wero1414/fm1-midi-dongle./README.md

# FM-1 MIDI dongle

A small stick that plugs into the M-VAVE FM-1's USB-C port and gives it a **TRS MIDI OUT** and an
**isolated TRS MIDI IN**. The FM-1 is a USB MIDI device, so the dongle is a USB host built on the
WCH **CH32X035G8U6** (the cheapest WCH part with a full-speed USB host). It works with any FM-1 firmware
that sends MIDI over USB: Melodee, SLOOP, Felucca, Hortator, stock.

- `DESIGN.md`: the locked design, verified pins, open items, firmware plan, cost.
- `BOM.csv`: parts with LCSC numbers and a *Verified* column.
- `fm1-midi-dongle.kicad_sch` / `.kicad_pro`: KiCad 10 schematic (ERC clean). Generated by `tools/gen_sch.py`.
- `fm1-midi-dongle.kicad_pcb`: the board with placement only (generated by `tools/gen_pcb.py`); routing is manual.
- `fm1_dongle.kicad_sym`, `fm1_dongle.pretty`, `fm1_dongle.3dshapes`: project symbols and the exact LCSC footprints
  (from EasyEDA) for every IC and connector. `tools/export_jlc.sh` makes the JLCPCB BOM.

Status (2026-10-17): schematic done; PCB floorplanned (20 x 26 mm, 4 layers, 0.8 mm, placement DRC clean),
routing not started; firmware not started.

## Hardware summary
- USB-C male plug to the FM-1 (host side, 56 kΩ Rp on CC), VBUS through an SY6280AAC load switch set to 1 A.
- USB-C female for 5 V in only (5.1 kΩ Rd on CC1/CC2), no data.
- MIDI OUT: 3.3 V TRS type A (10 Ω tip, 33 Ω ring), PJ-320D jacks.
- MIDI IN: H11L1SM optocoupler, 220 Ω, 1N4148 reverse diode, TRS type A.
- Programming: WCH-LinkE on three bare pads (3V3 / PC18 DIO / GND), no connector.

## License
Hardware: CERN-OHL-P-2.0 (proposed; change if you prefer).
