wero1414/fm1-midi-dongle./case/out/alu_ghost.png

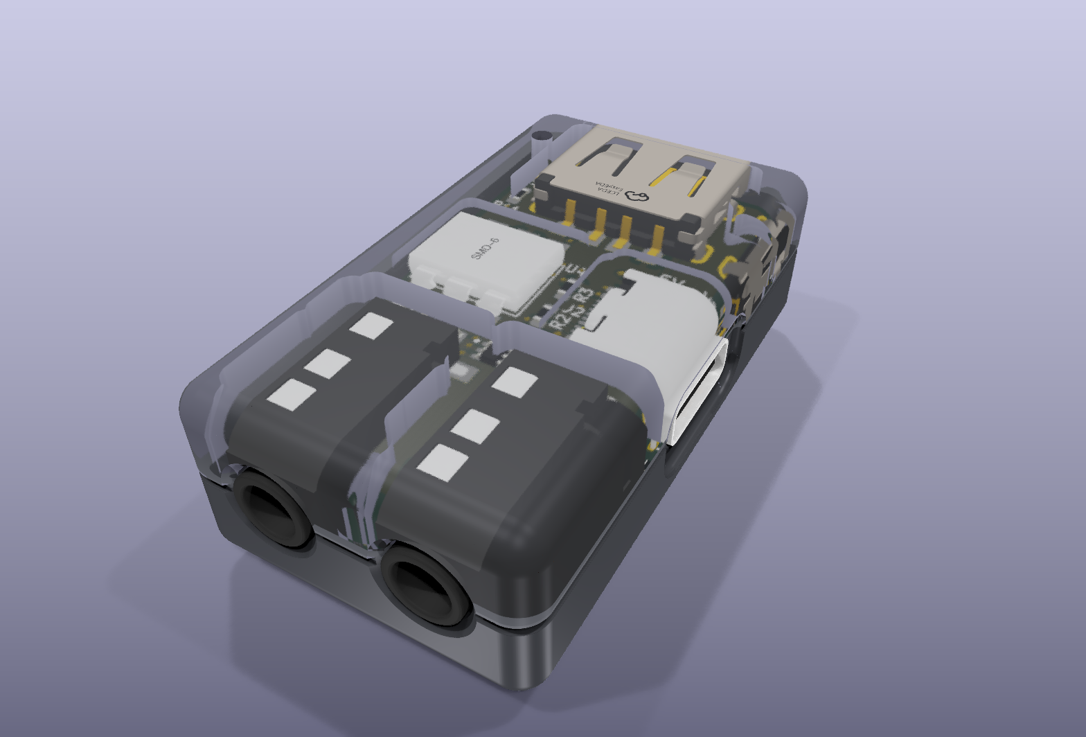
case/out/alu_ghost.png
