wero1414/fm1-midi-dongle./case/out/alu_open.png

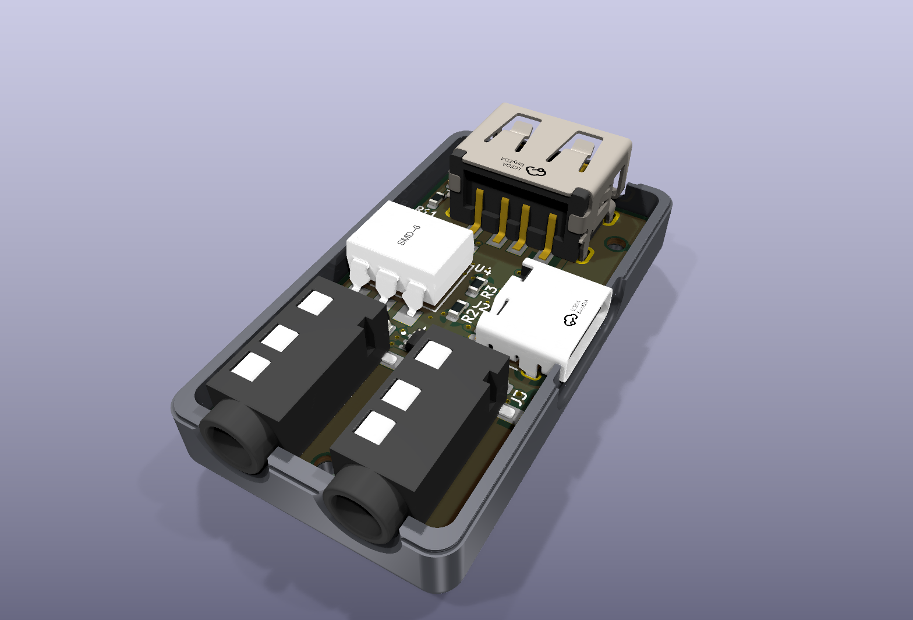
case/out/alu_open.png
