wero1414/fm1-midi-dongle./case/out/alu_side.png

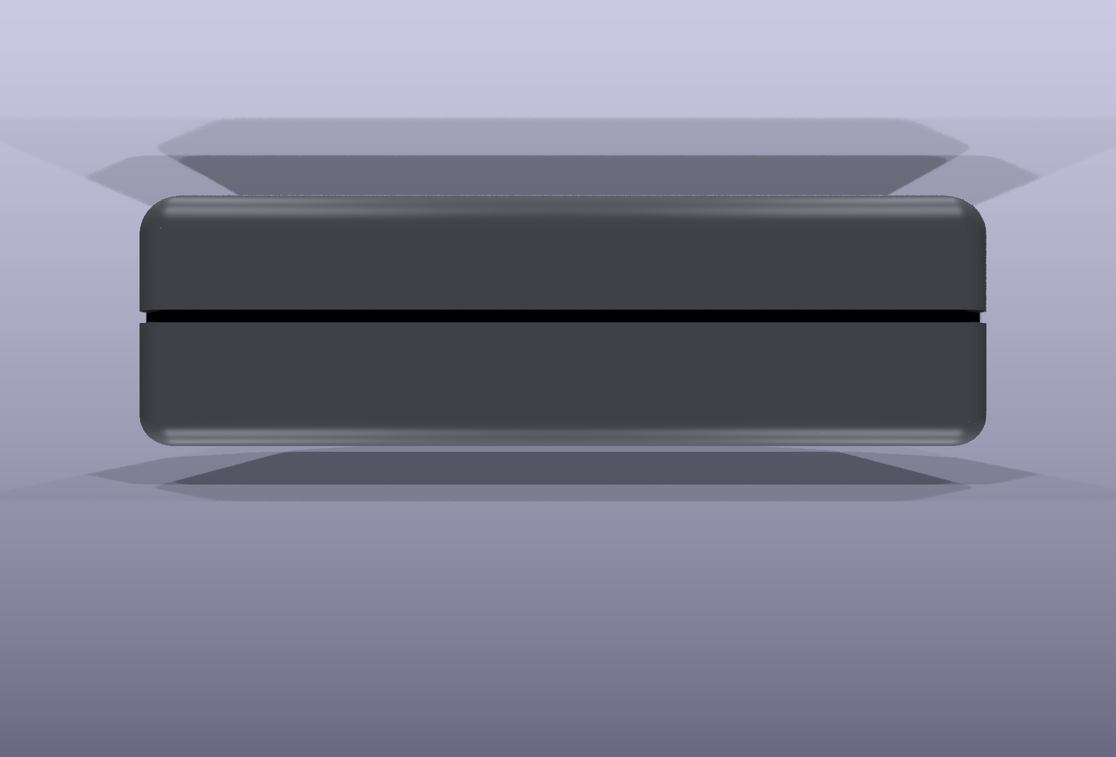
case/out/alu_side.png
