wero1414/fm1-midi-dongle./case/out/case_ghost.png

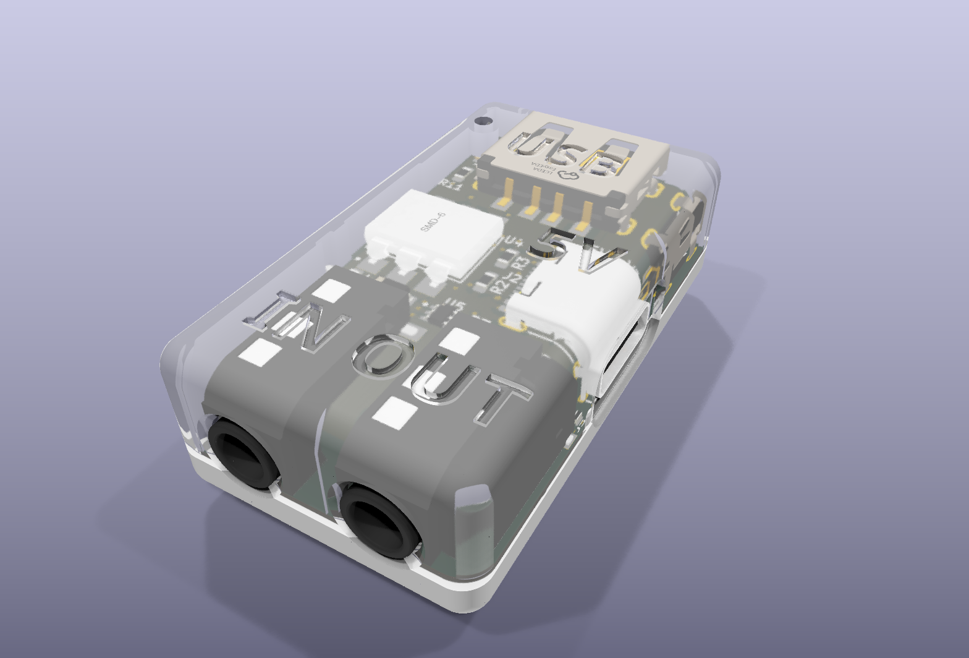
case/out/case_ghost.png
