wero1414/fm1-midi-dongle./case/out/case_open.png

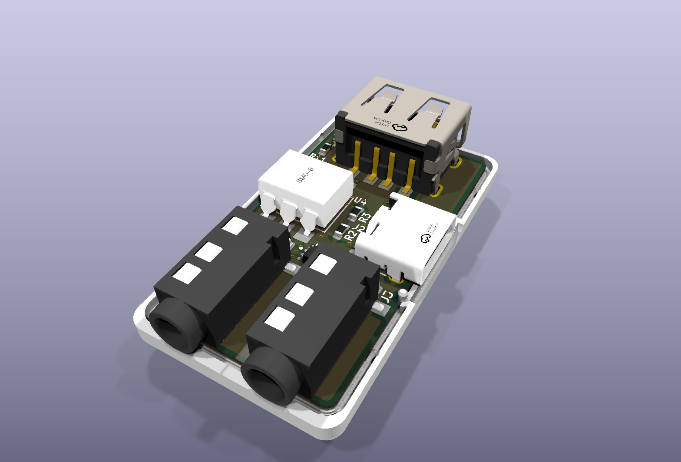
case/out/case_open.png
