wero1414/fm1-midi-dongle./case/out/case_side.png

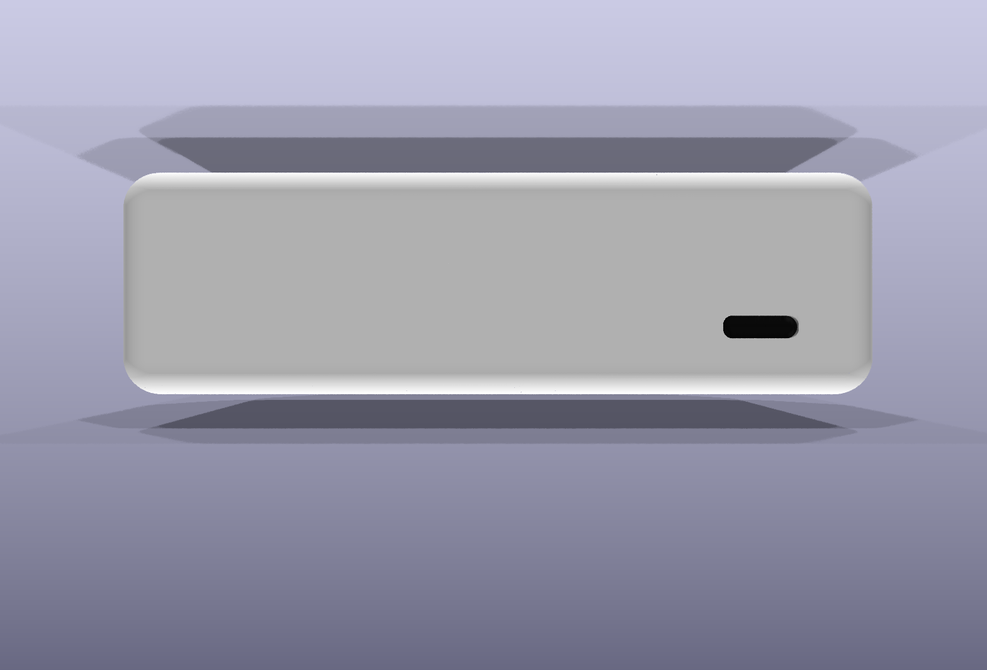
case/out/case_side.png
