wero1414/fm1-midi-dongle./case/out/case_underside.png

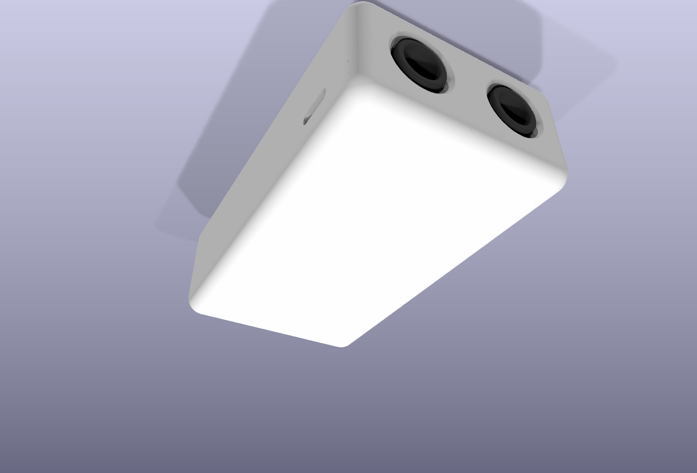
case/out/case_underside.png
