wero1414/fm1-midi-dongle./case/out/case_usb_end.png

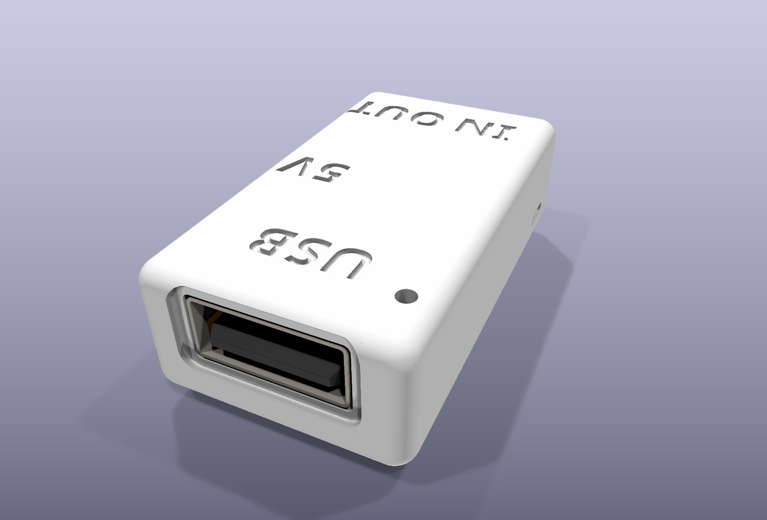
case/out/case_usb_end.png
