wero1414/fm1-midi-dongle./case/out/render_bottom.png

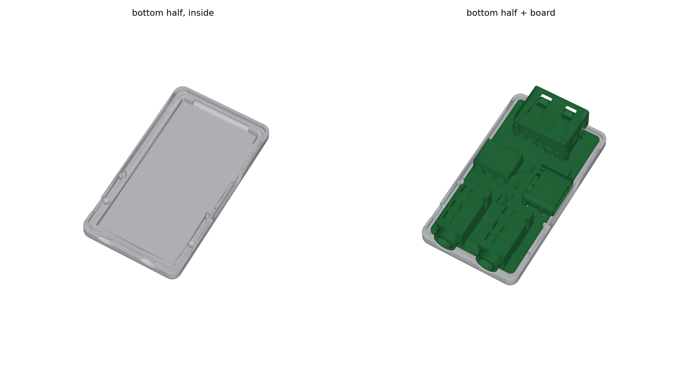
case/out/render_bottom.png
