wero1414/fm1-midi-dongle./case/out/render_exploded.png

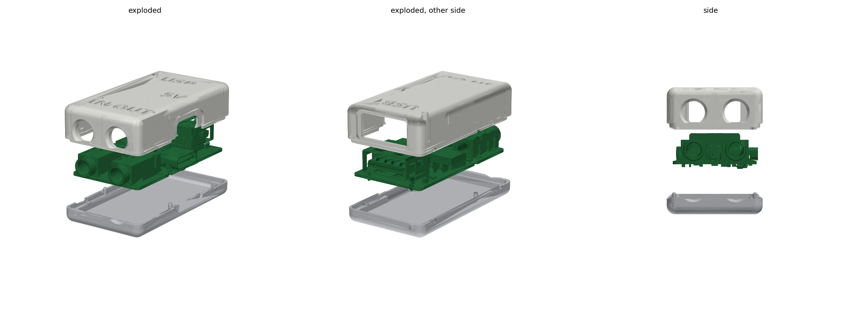
case/out/render_exploded.png
