wero1414/fm1-midi-dongle./case/out/render_halves.png

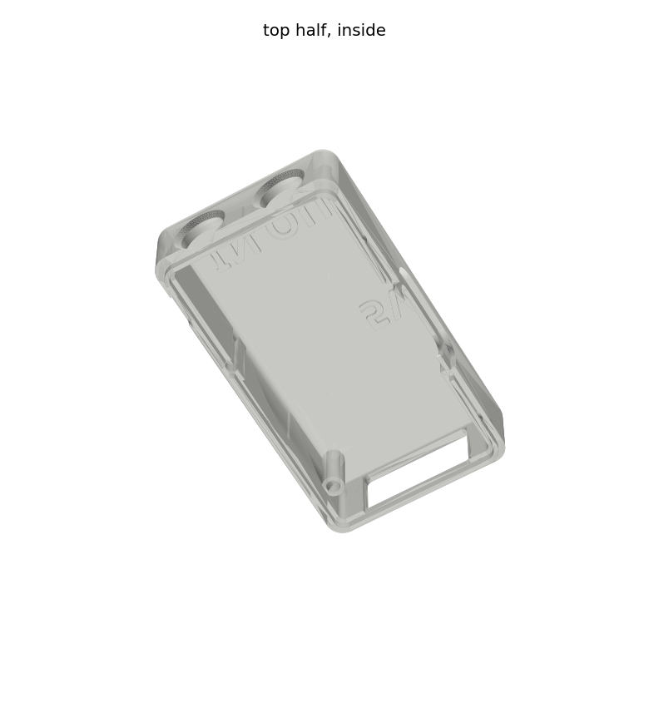
case/out/render_halves.png
