wero1414/fm1-midi-dongle./case/out/sheet_ghost.png

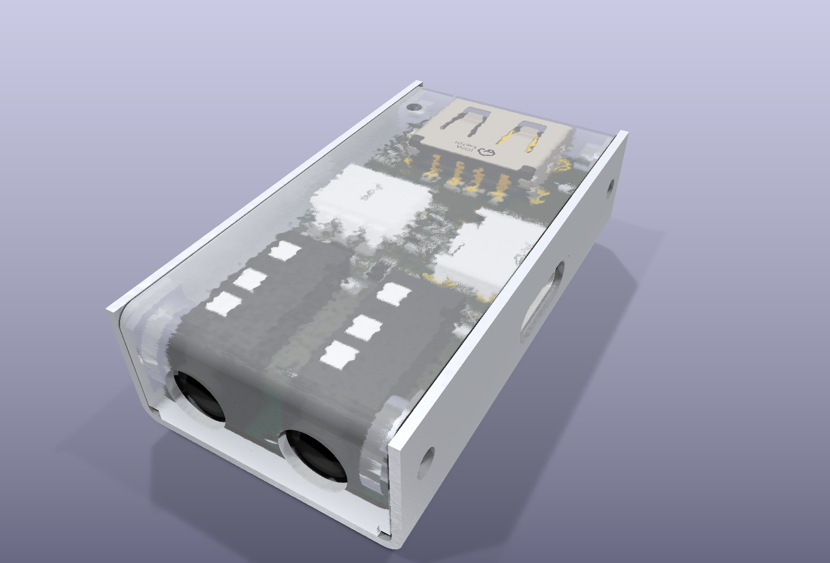
case/out/sheet_ghost.png
