wero1414/fm1-midi-dongle./case/out/sheet_open.png

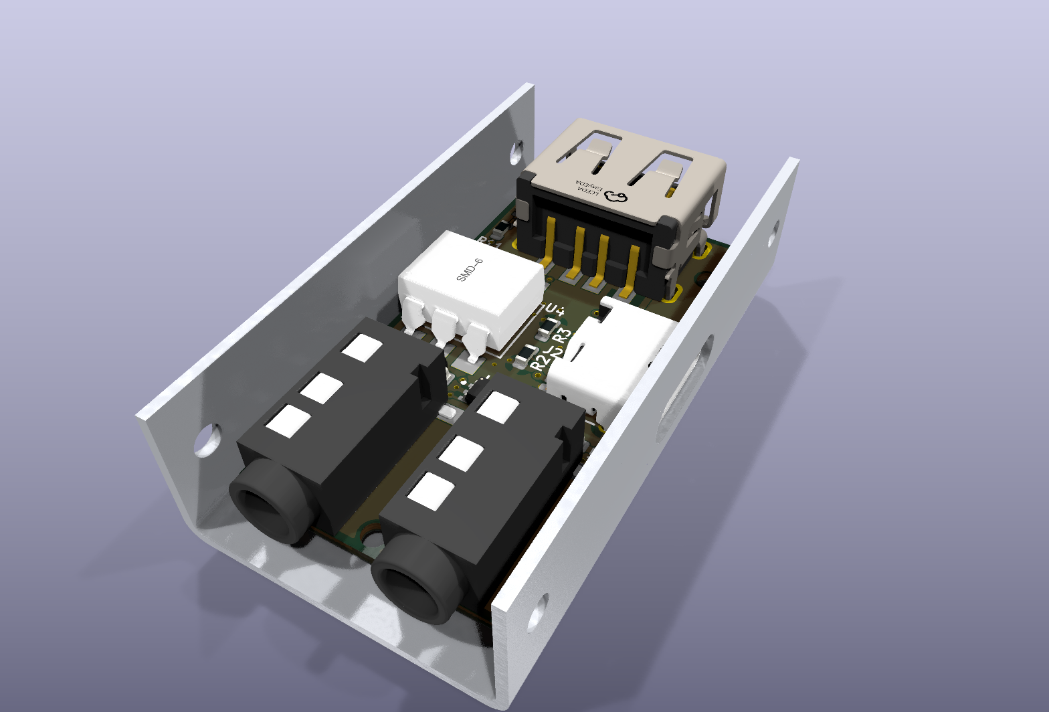
case/out/sheet_open.png
