wero1414/fm1-midi-dongle./case/out/sheet_side.png

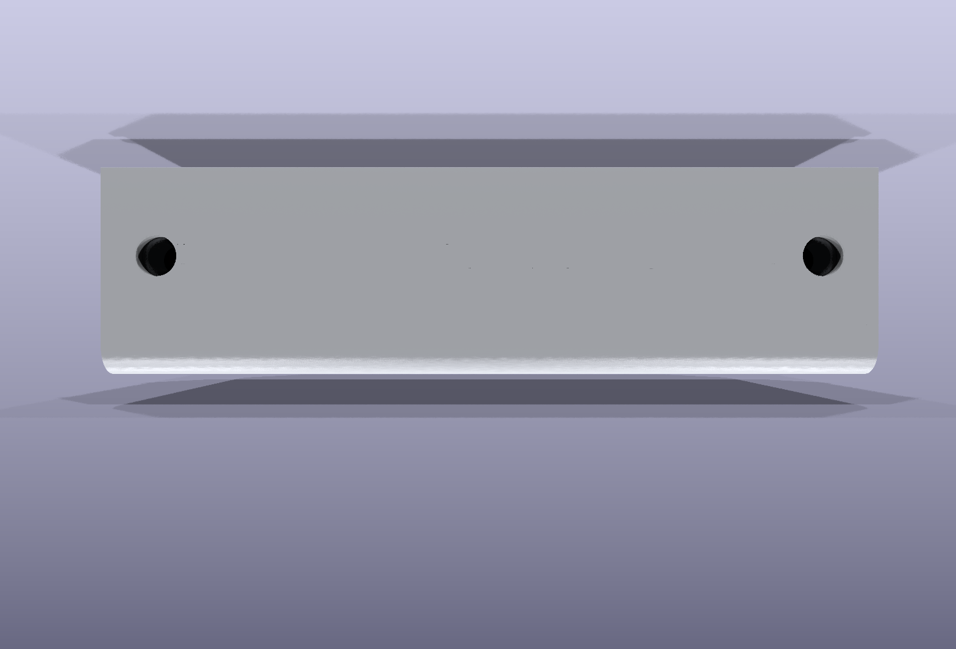
case/out/sheet_side.png
