wero1414/fm1-midi-dongle./docs/pcb3d_iso.png

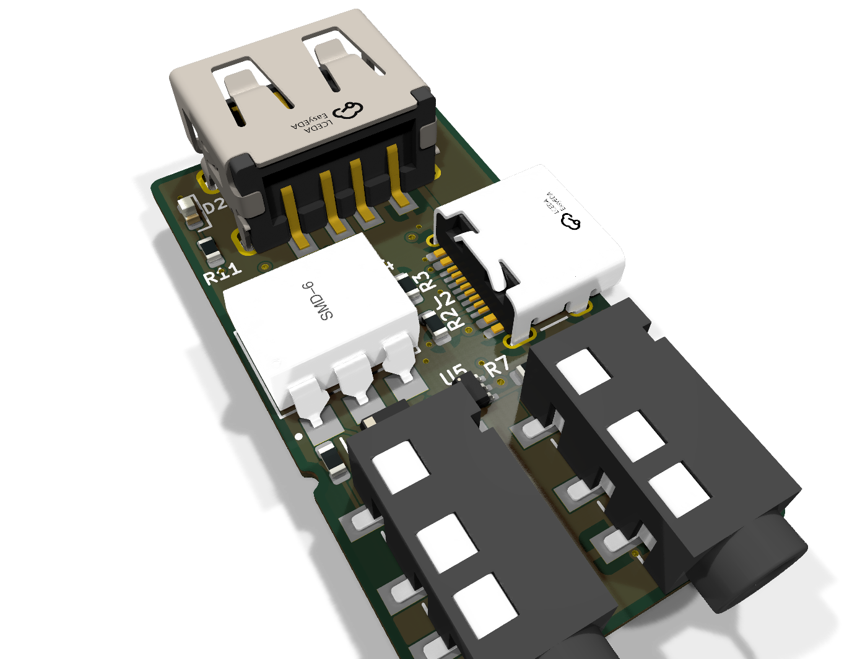
docs/pcb3d_iso.png
