wero1414/fm1-midi-dongle./docs/pcb3d_top.png

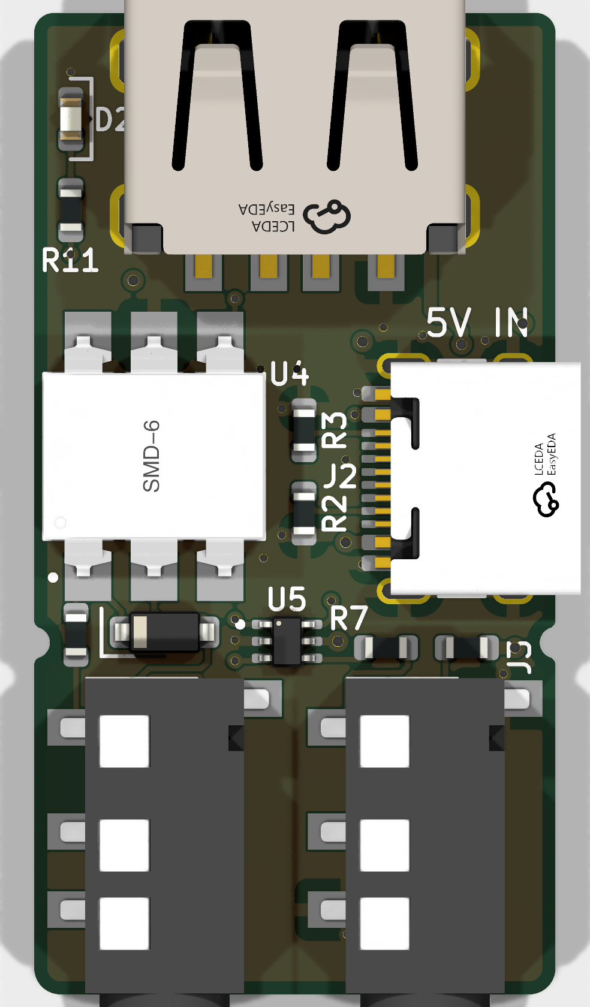
docs/pcb3d_top.png
