wero1414/fm1-midi-dongle./docs/pcb_bot.png

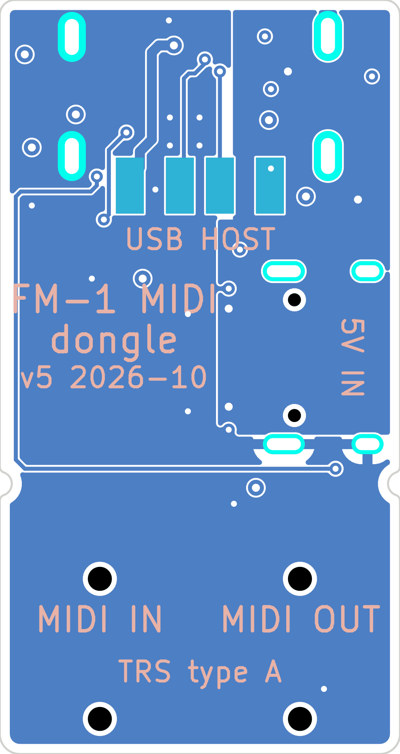
docs/pcb_bot.png
