wero1414/fm1-midi-dongle./docs/pcb_nets.png

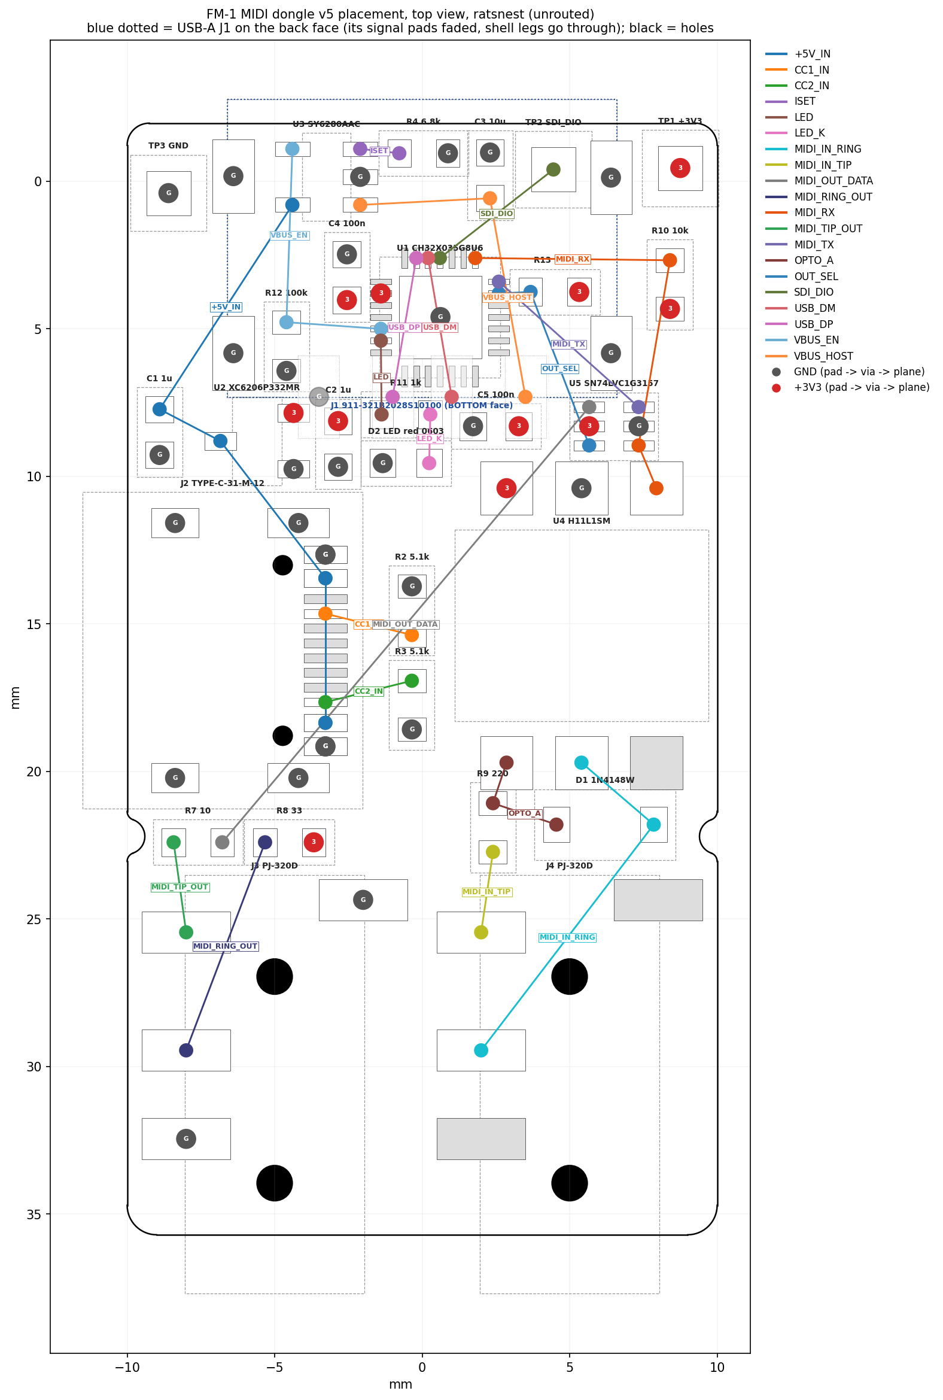
docs/pcb_nets.png
