wero1414/fm1-midi-dongle./docs/pcb_nets_top.png

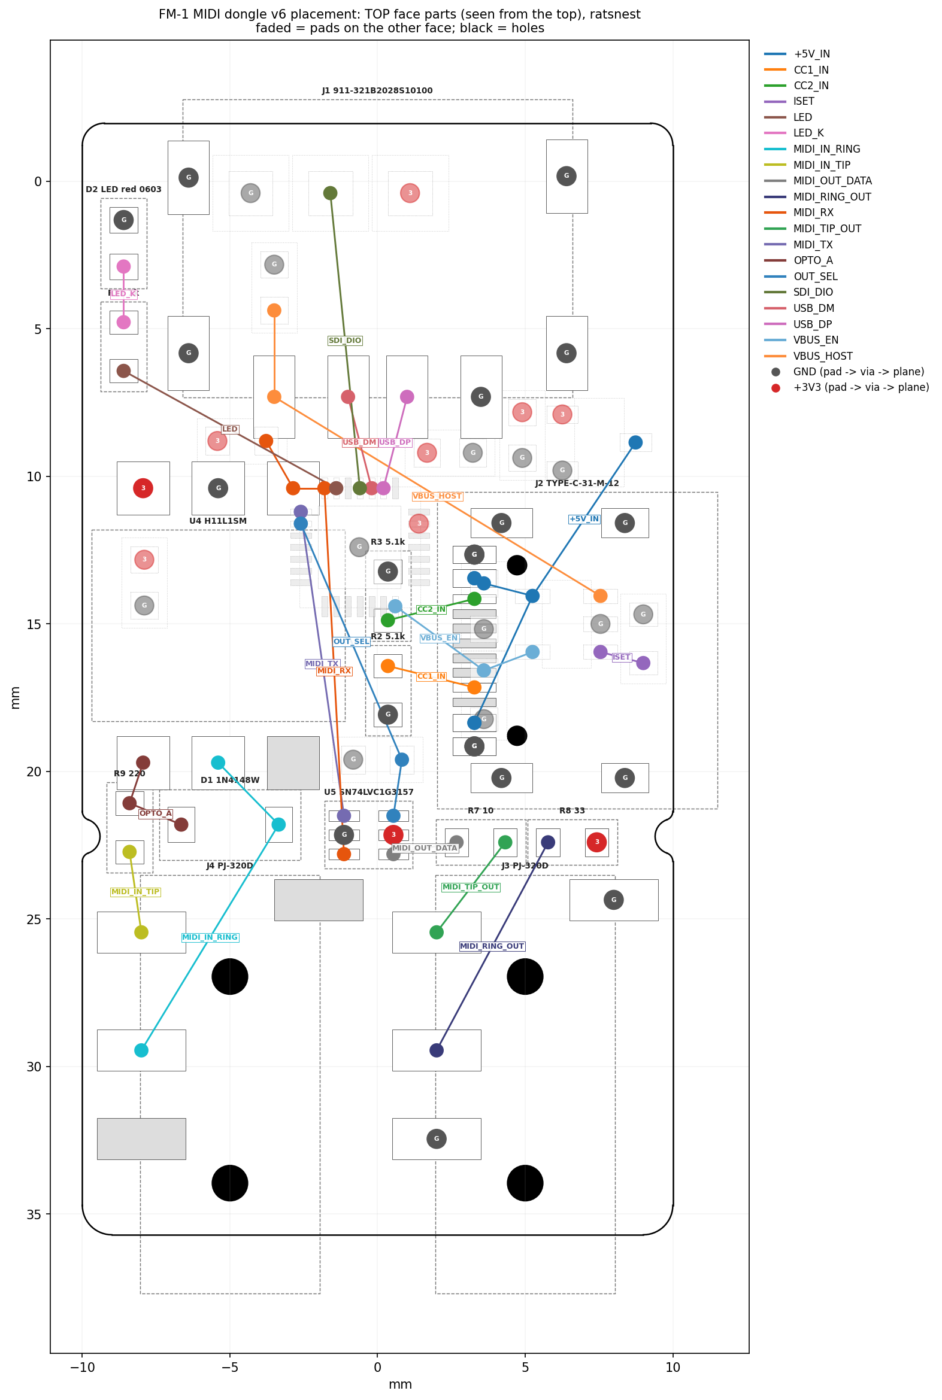
docs/pcb_nets_top.png
