wero1414/fm1-midi-dongle./docs/pcb_route.png

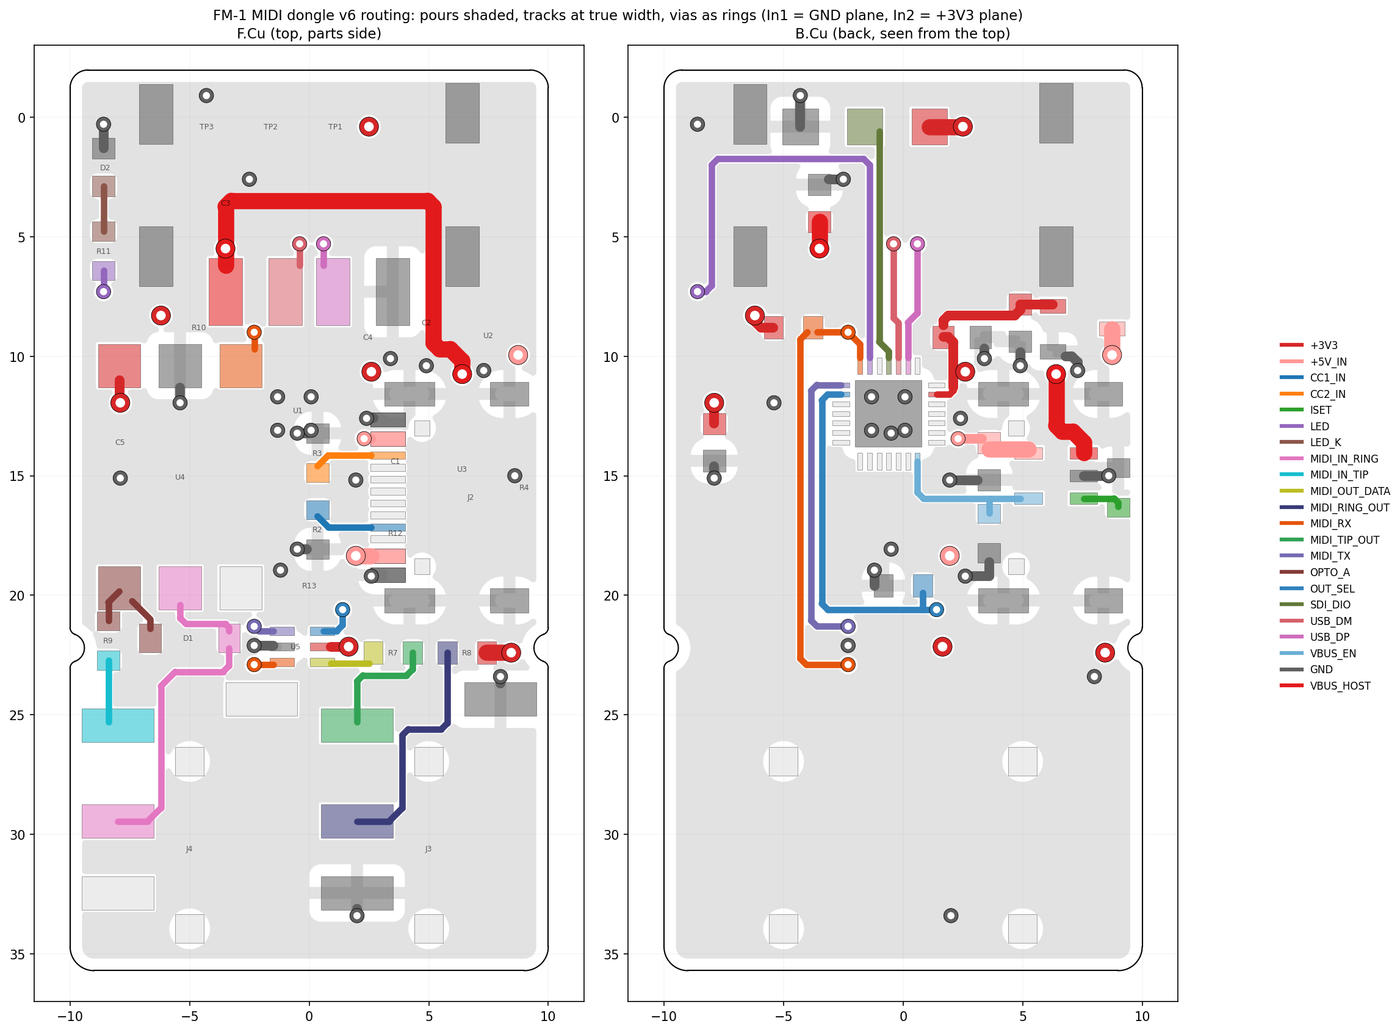
docs/pcb_route.png
