wero1414/fm1-midi-dongle./docs/pcb_top.png

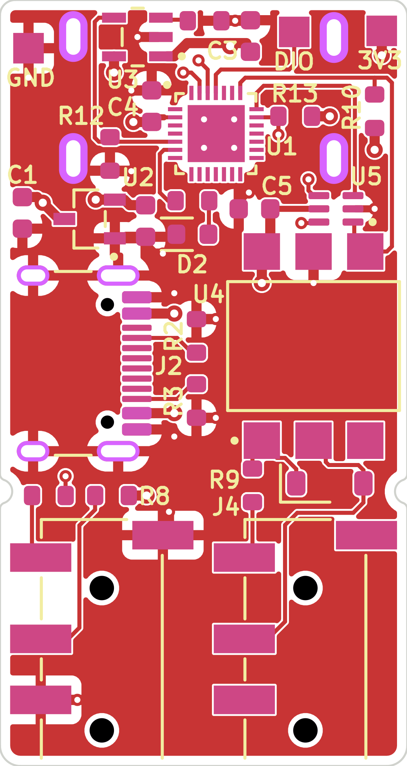
docs/pcb_top.png
