wero1414/fm1-midi-dongle./docs/route_bot.png

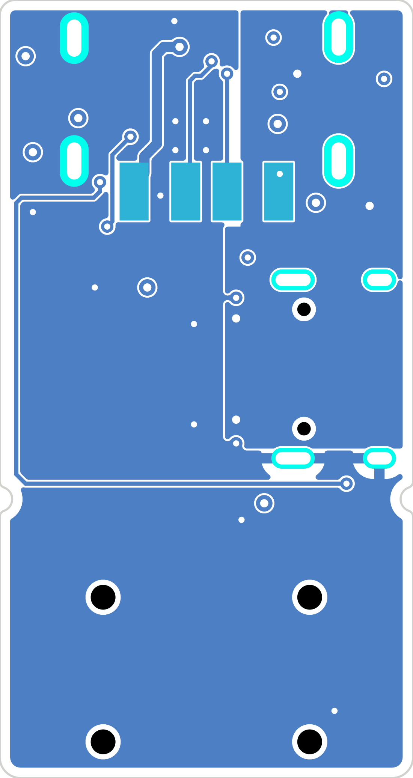
docs/route_bot.png
