wero1414/fm1-midi-dongle./docs/route_in1.png

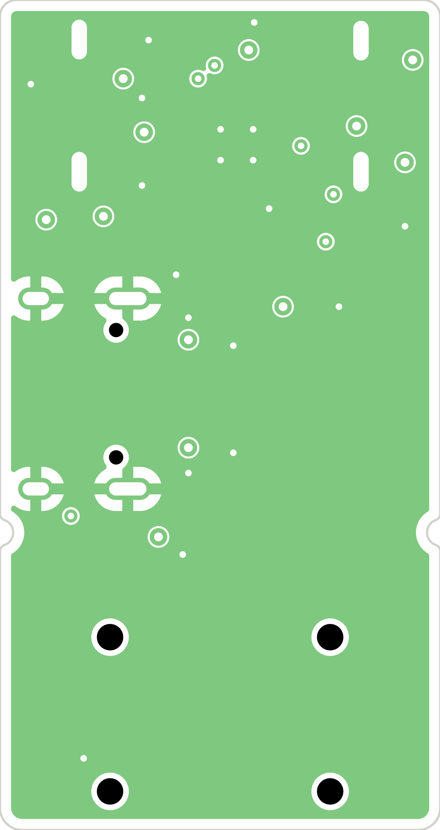
docs/route_in1.png
