wero1414/fm1-midi-dongle./docs/route_in2.png

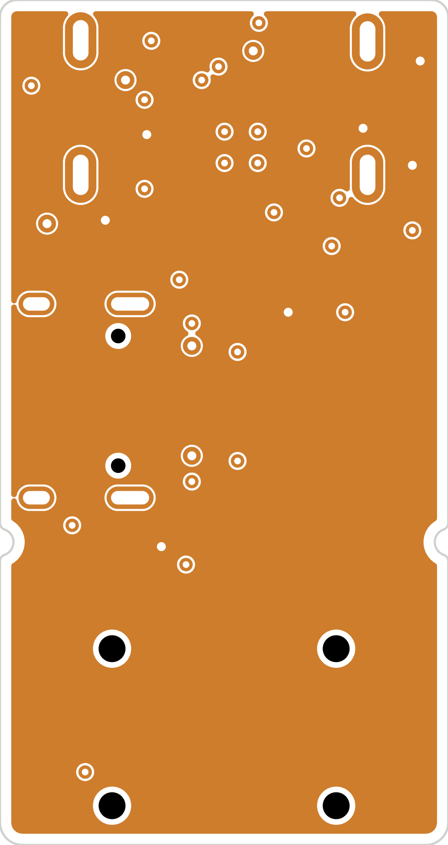
docs/route_in2.png
