wero1414/fm1-midi-dongle./docs/route_top.png

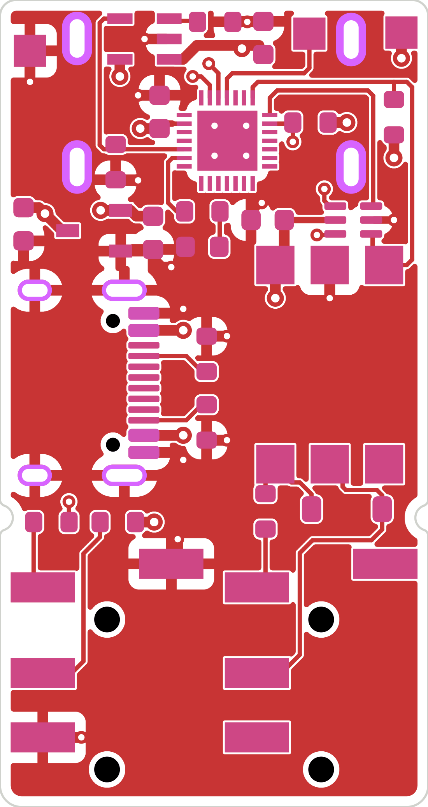
docs/route_top.png
