wero1414/fm1-midi-dongle./docs/schematic.png

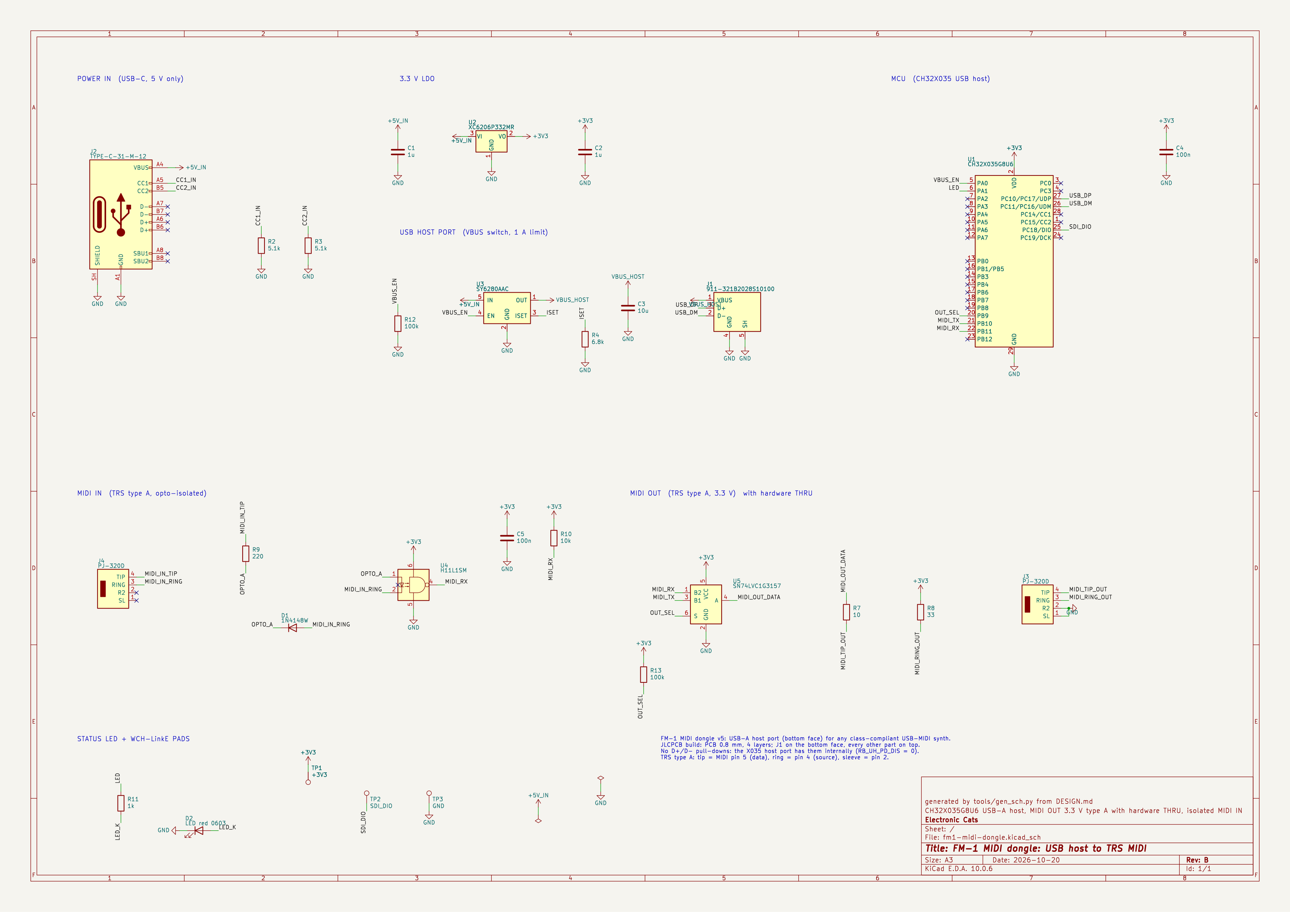
docs/schematic.png
