wero1414/fm1-midi-dongle./docs/silk_bot.png

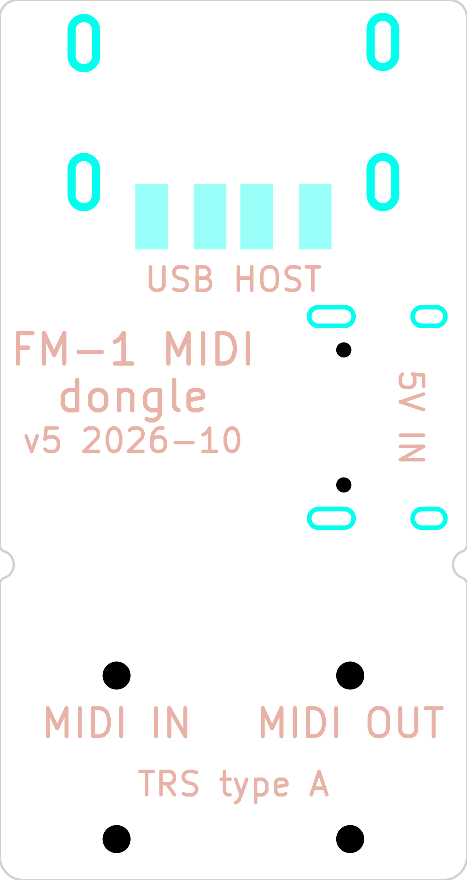
docs/silk_bot.png
