wero1414/fm1-midi-dongle./docs/silk_top.png

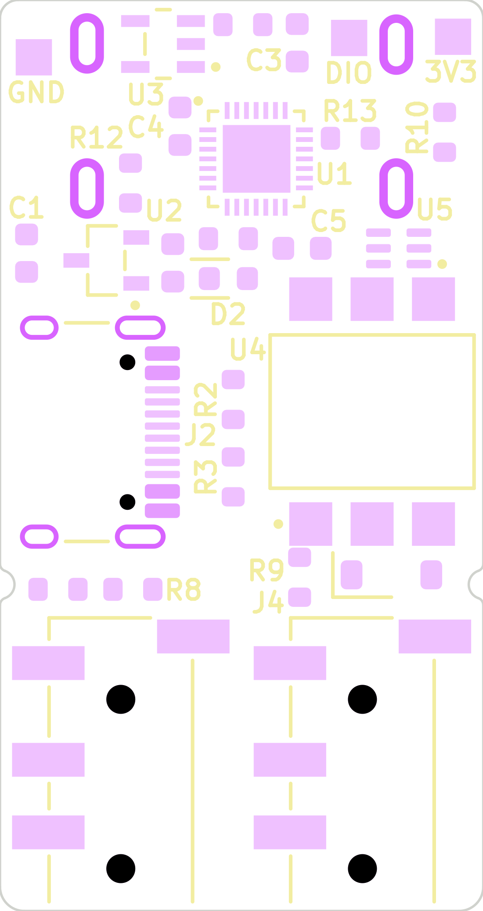
docs/silk_top.png
