wero1414/fm1-midi-dongle./docs/views/bottom.png

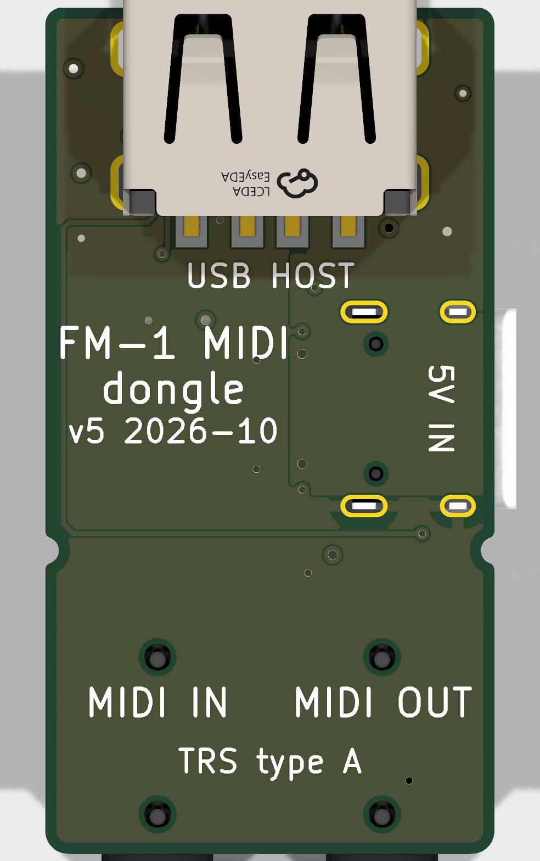
docs/views/bottom.png
