wero1414/fm1-midi-dongle./docs/views/iso_back.png

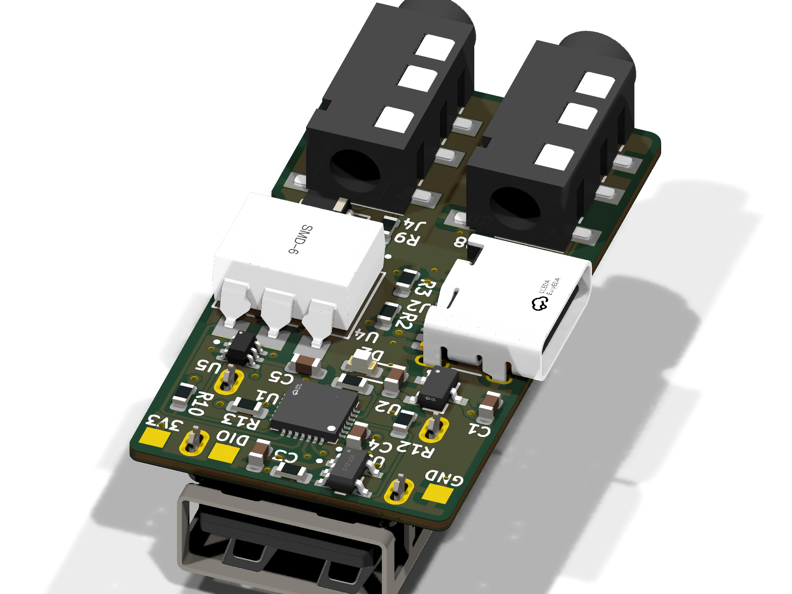
docs/views/iso_back.png
