wero1414/fm1-midi-dongle./docs/views/iso_front.png

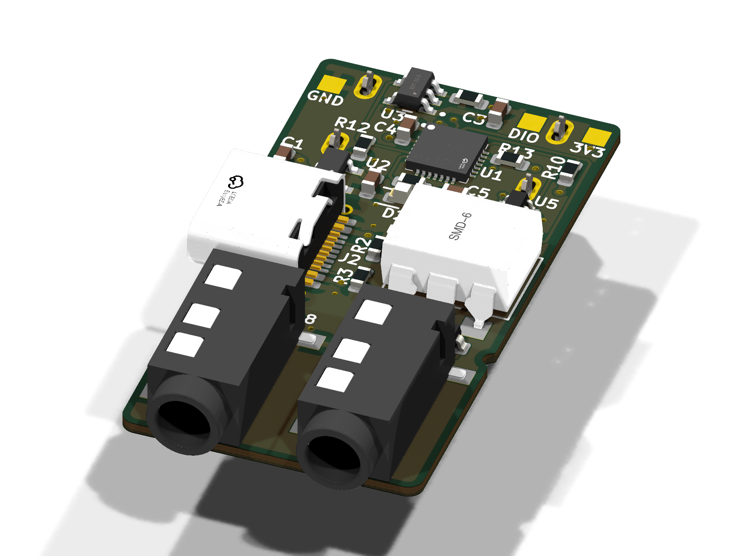
docs/views/iso_front.png
