wero1414/fm1-midi-dongle./docs/views/iso_under.png

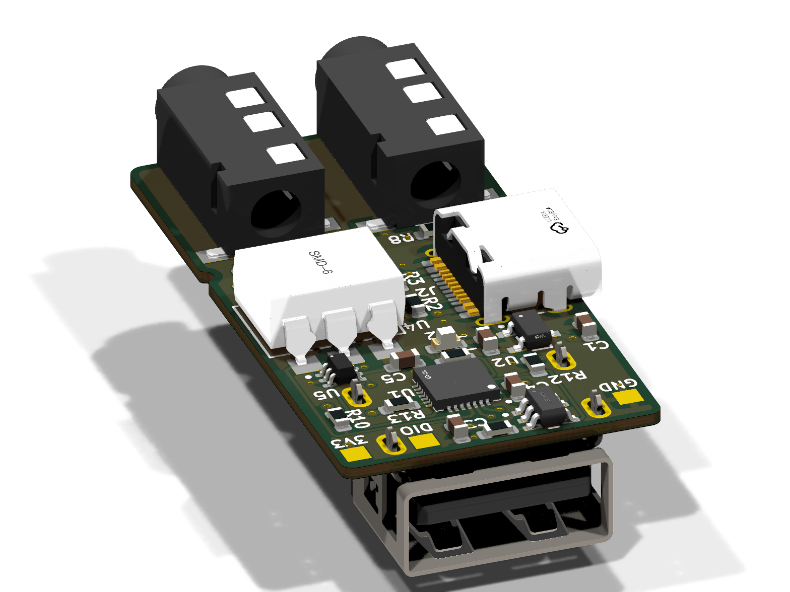
docs/views/iso_under.png
