wero1414/fm1-midi-dongle./docs/views/side_front.png

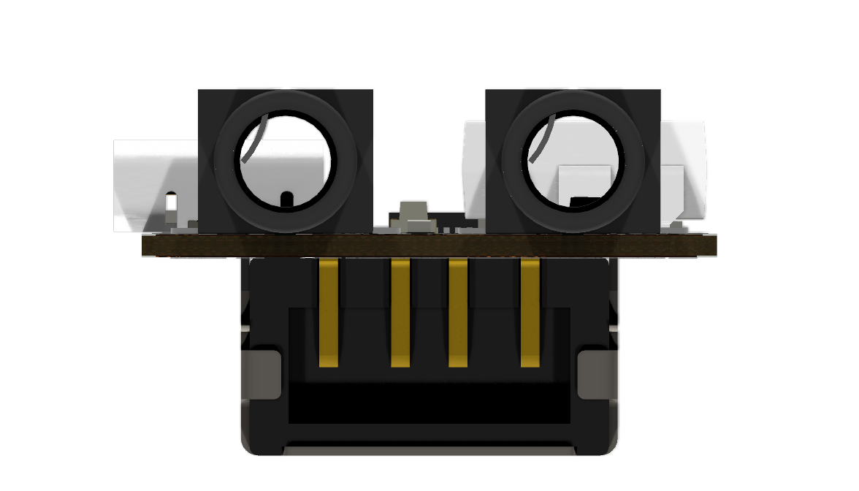
docs/views/side_front.png
