wero1414/fm1-midi-dongle./docs/views/side_left.png

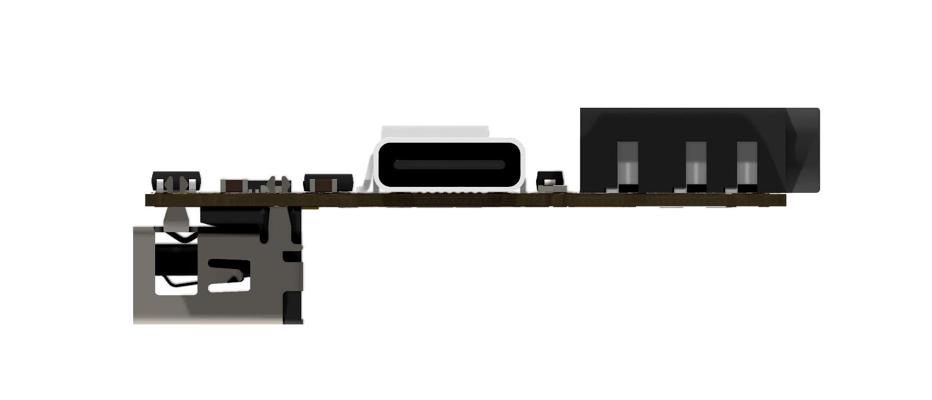
docs/views/side_left.png
