wero1414/fm1-midi-dongle./docs/views/top.png

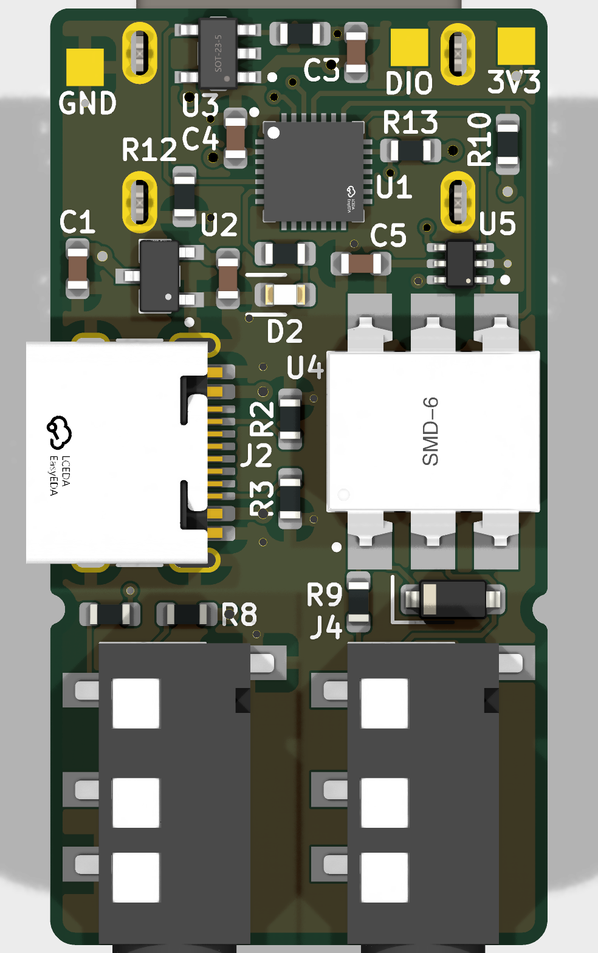
docs/views/top.png
