wero1414/fm1-midi-dongle./case/out/sheet_assembly.step

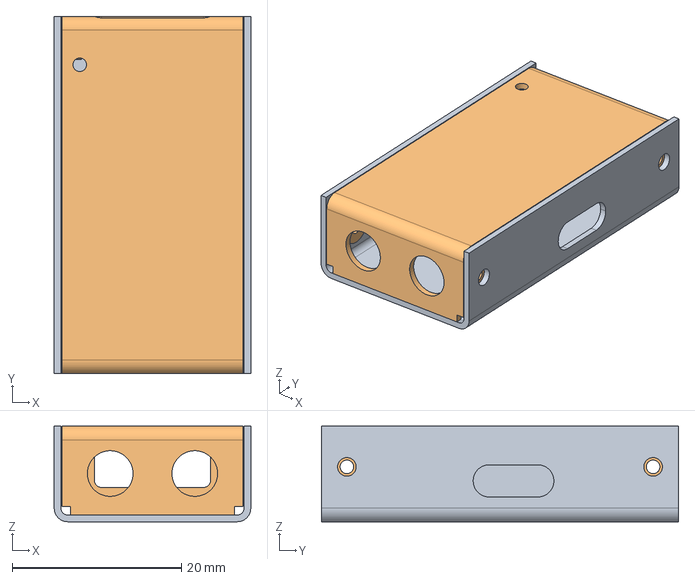
[picture p43: CAD file, 2026-10-21]
case/out/sheet_assembly.step
23.2 x 42.2 x 11.3 mm
