wero1414/fm1-midi-dongle./case/out/alu_assembly.step

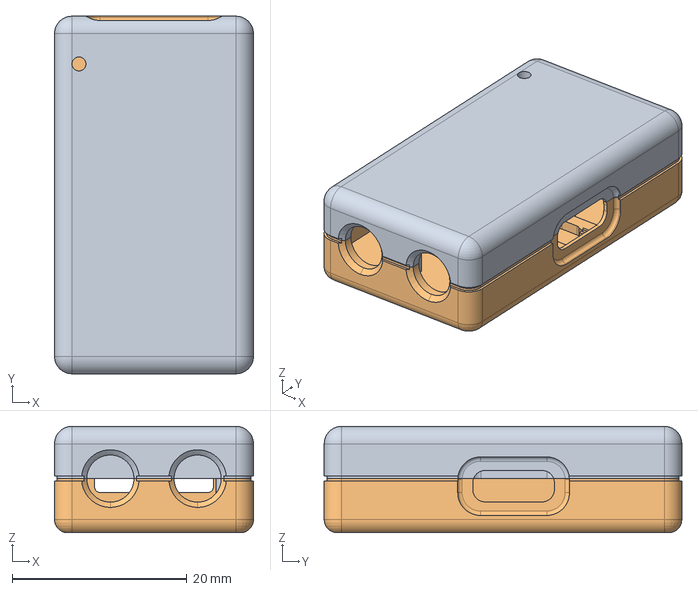
[picture p44: CAD file, 2026-10-21]
case/out/alu_assembly.step
22.8 x 41.0 x 12.2 mm
