wero1414/fm1-midi-dongle./case/out/print_assembly.step

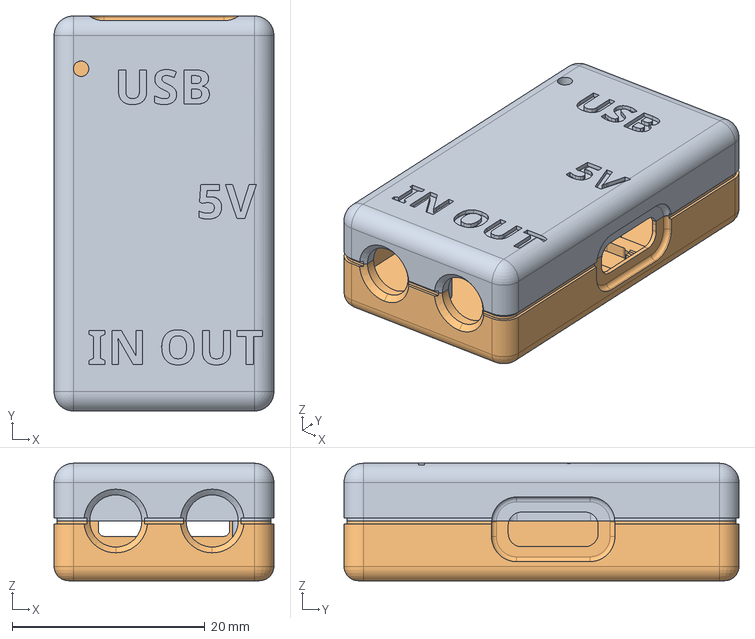
[picture p45: CAD file, 2026-10-21]
case/out/print_assembly.step
22.8 x 41.0 x 12.2 mm
