wero1414/fm1-midi-dongle./case/out/case_assembly.step

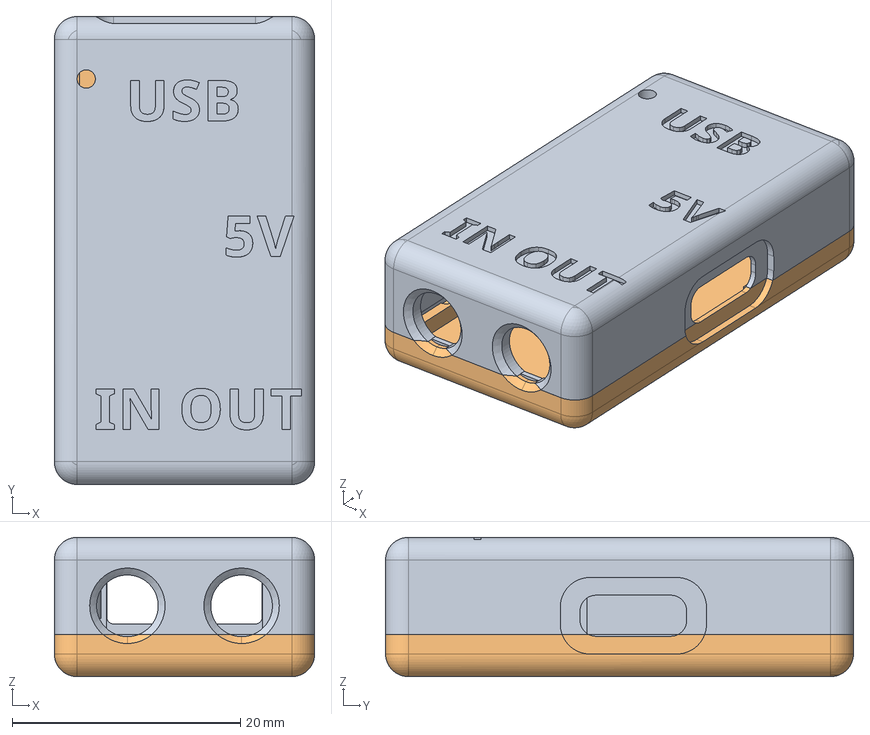
[picture p46: CAD file, 2026-10-20]
case/out/case_assembly.step
22.8 x 41.0 x 12.2 mm
