wero1414/fm1-midi-dongle./case/out/sheet_top.step

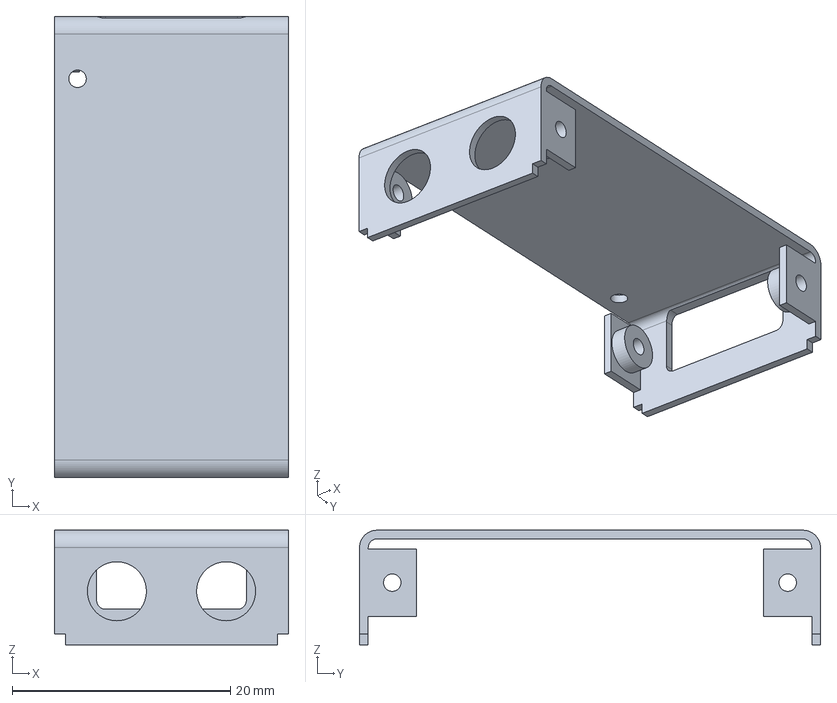
[picture p47: CAD file, 2026-10-21]
case/out/sheet_top.step
21.4 x 42.2 x 10.5 mm
