wero1414/fm1-midi-dongle./case/out/alu_bottom.step

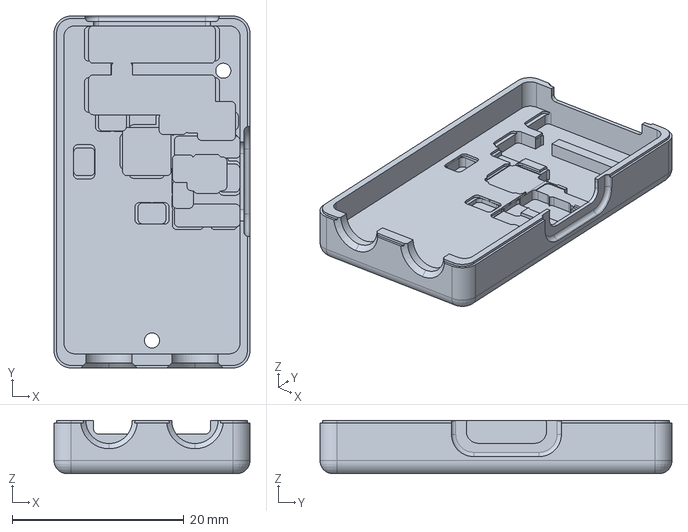
[picture p48: CAD file, 2026-10-21]
case/out/alu_bottom.step
22.8 x 41.0 x 6.20 mm
