wero1414/fm1-midi-dongle./case/out/sheet_bottom.step

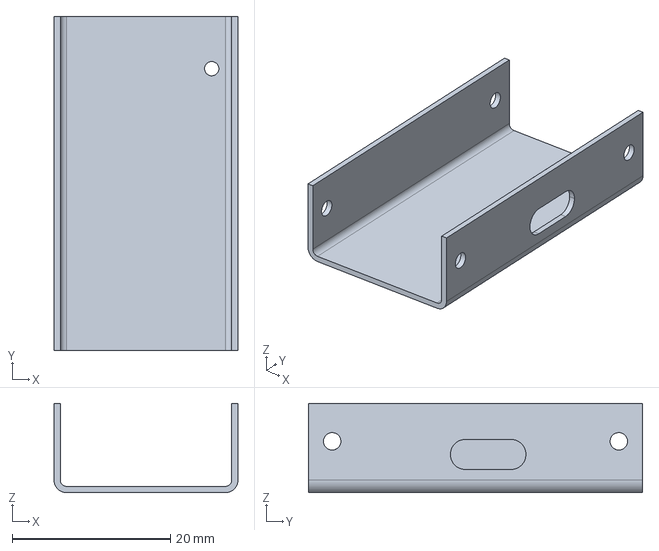
[picture p49: CAD file, 2026-10-21]
case/out/sheet_bottom.step
23.2 x 42.2 x 11.3 mm
