wero1414/fm1-midi-dongle./case/out/sheet_hardware.step

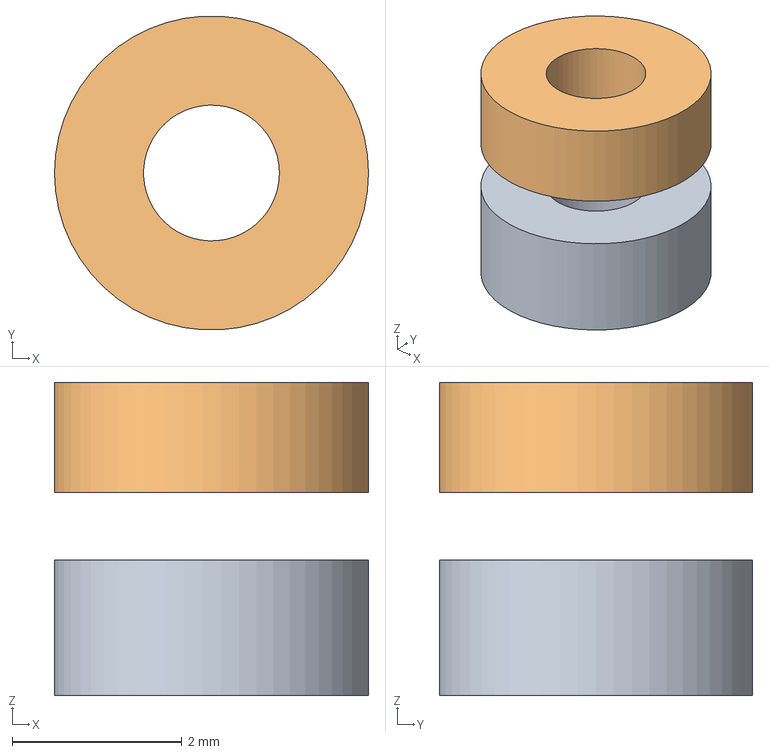
[picture p50: CAD file, 2026-10-21]
case/out/sheet_hardware.step
3.70 x 3.69 x 3.69 mm
