wero1414/fm1-midi-dongle./case/out/print_top.step

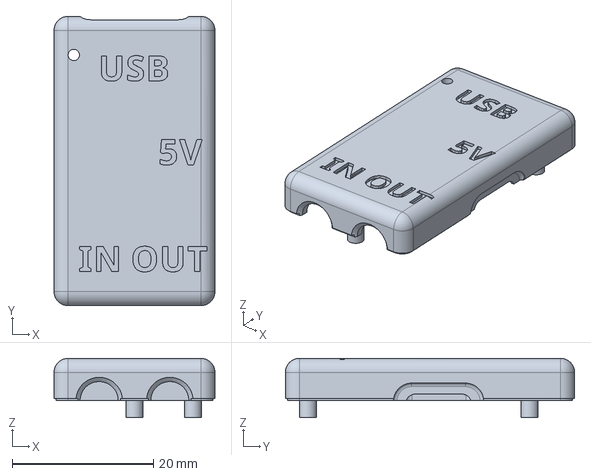
[picture p52: CAD file, 2026-10-21]
case/out/print_top.step
22.8 x 41.0 x 8.40 mm
