wero1414/fm1-midi-dongle./case/out/case_bottom.step

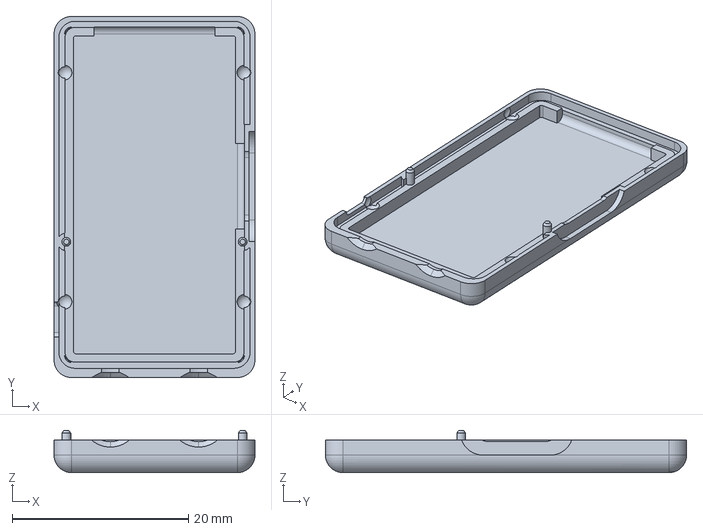
[picture p53: CAD file, 2026-10-20]
case/out/case_bottom.step
22.8 x 41.0 x 4.79 mm
