wero1414/fm1-midi-dongle./case/out/case_top_print.stl

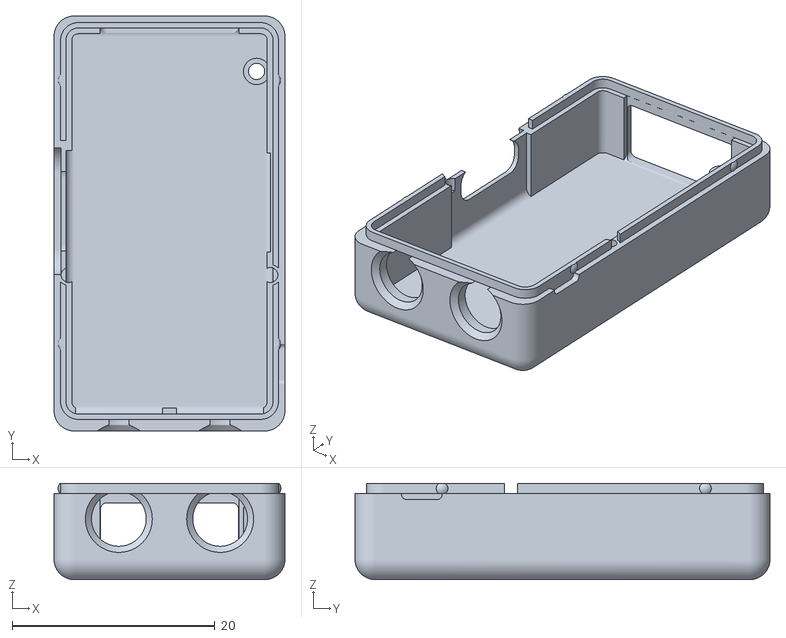
[picture p54: CAD file, 2026-10-20]
case/out/case_top_print.stl
22.8 x 41.0 x 9.50
