wero1414/fm1-midi-dongle./(list of files, cad)

Other CAD files:
case/out/print_bottom.step
case/out/print_bottom_print.stl
case/out/print_top_print.stl
case/out/case_bottom_print.stl
case/out/case_top.step
case/out/alu_bottom.stl
case/out/alu_top.stl
case/out/case_bottom.stl
case/out/case_top.stl
case/out/print_top.stl
case/out/sheet_bottom.stl
case/out/sheet_hardware.stl
case/out/sheet_top.stl
