wero1414/fm1-midi-dongle./case/out/print_exploded.png

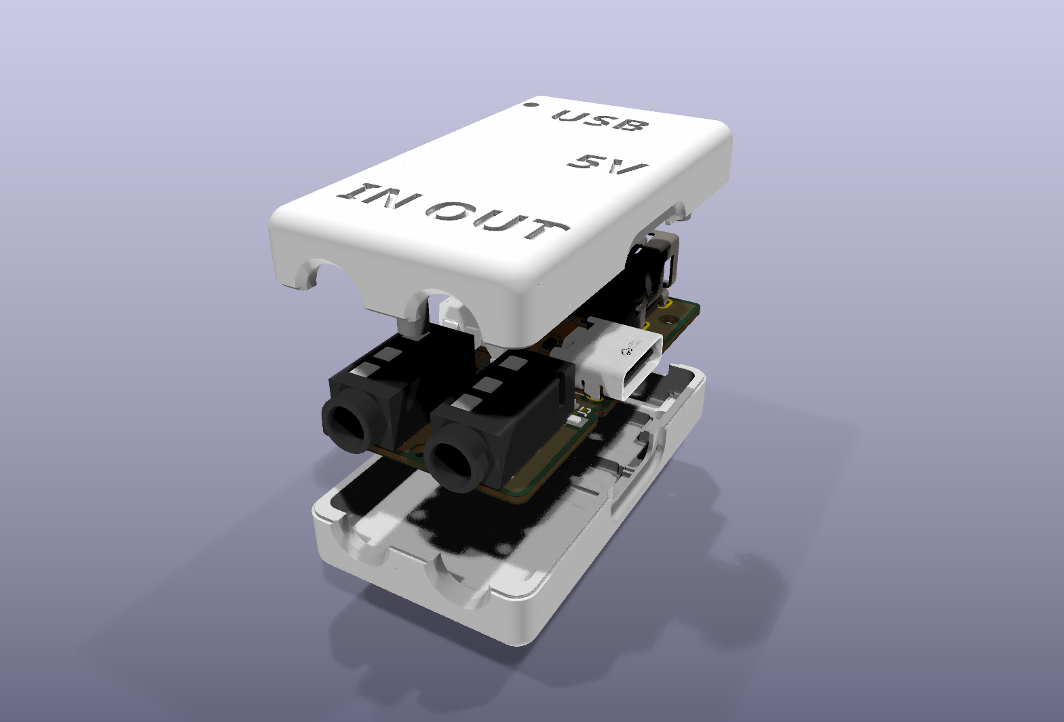
case/out/print_exploded.png
