wero1414/fm1-midi-dongle./case/out/print_ghost.png

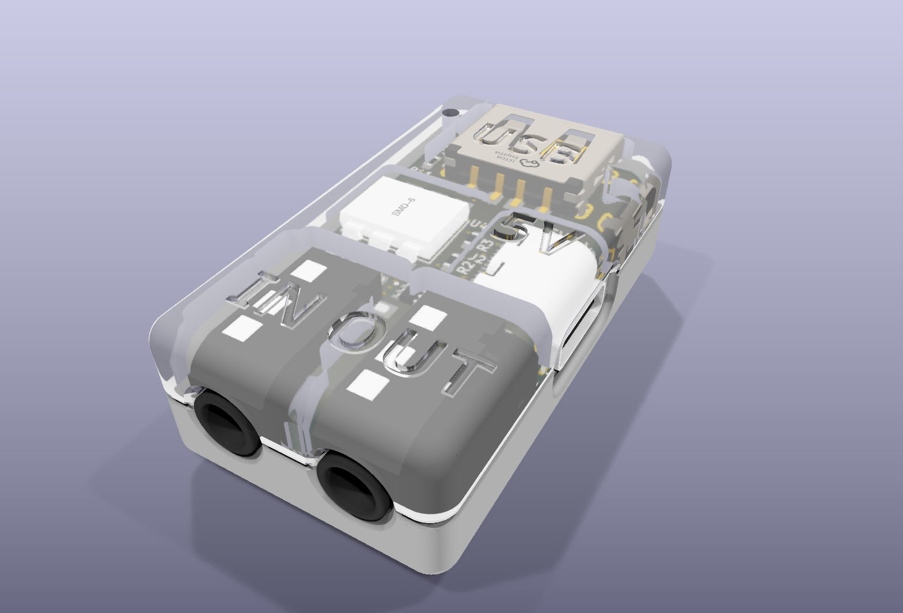
case/out/print_ghost.png
