wero1414/fm1-midi-dongle./case/out/print_open.png

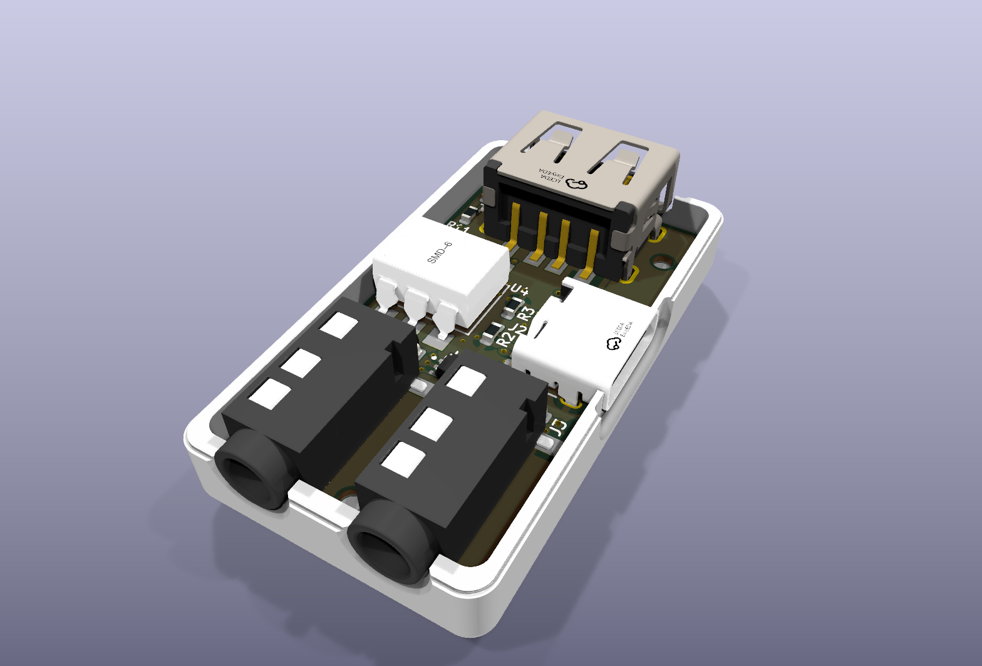
case/out/print_open.png
