wero1414/fm1-midi-dongle./case/out/render_assembled.png

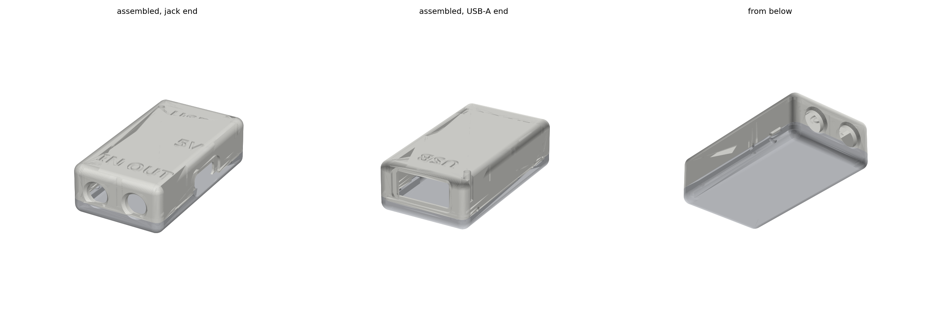
case/out/render_assembled.png
