wero1414/fm1-midi-dongle./fm1-midi-dongle.kicad_pcb

## KiCad design fm1-midi-dongle.kicad_pcb (2026-10-21)

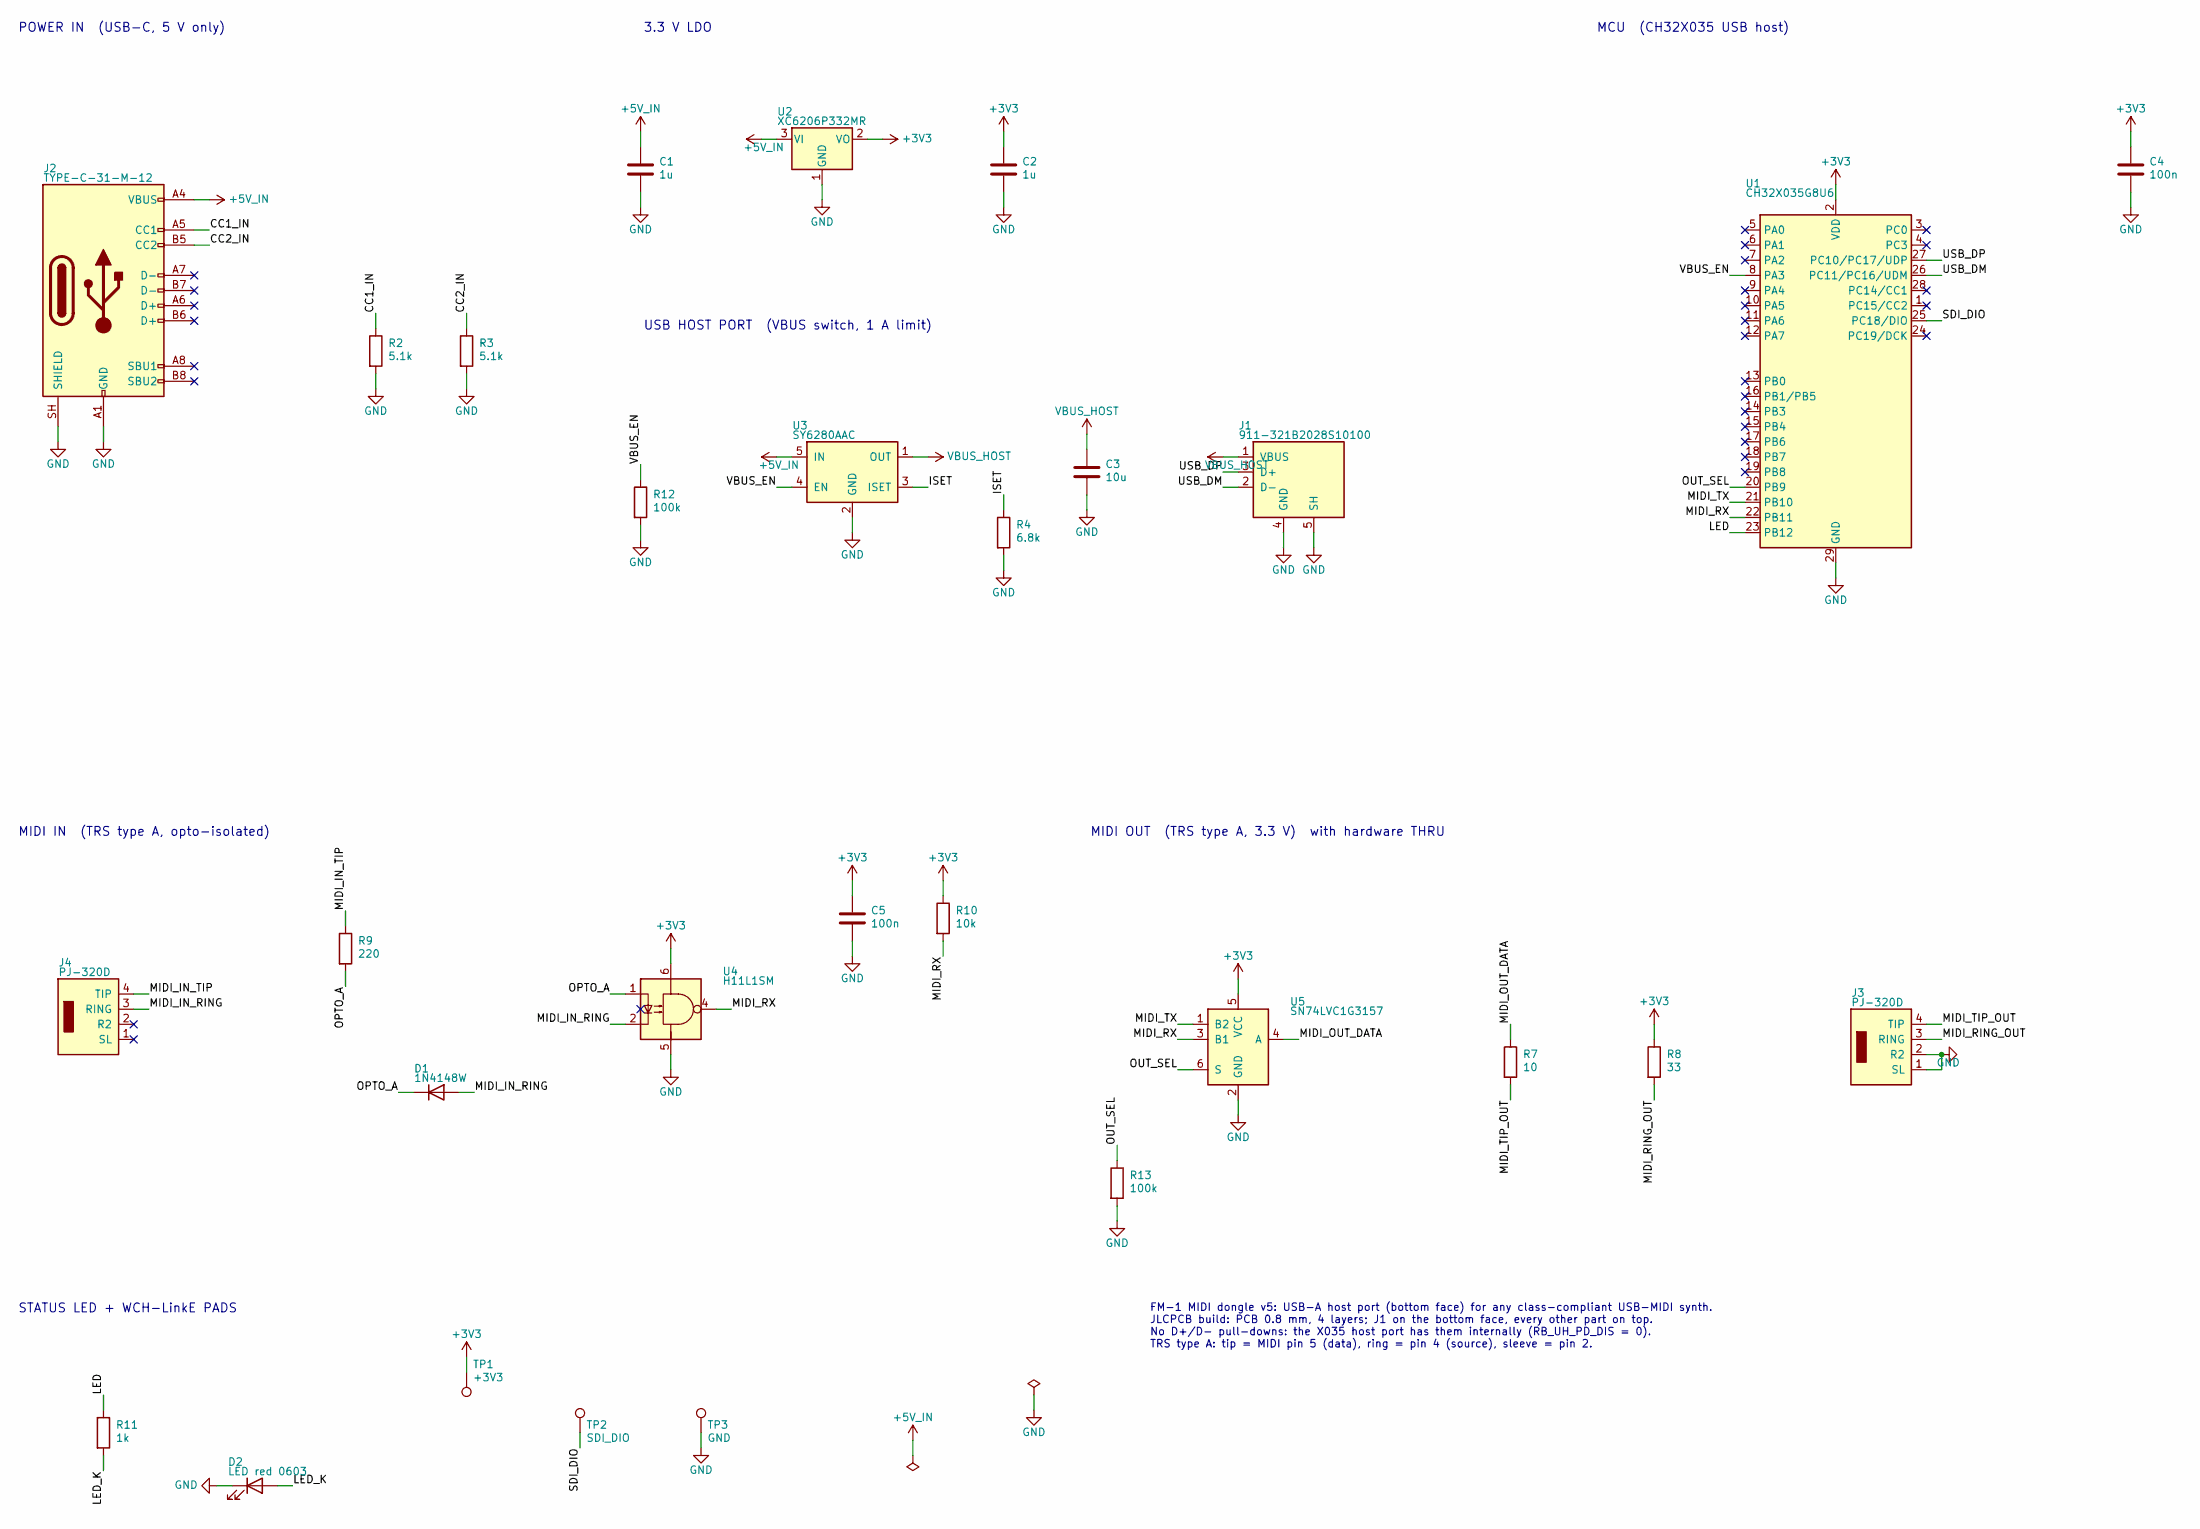
[picture p59: schematic fm1-midi-dongle.kicad_sch, FM-1 MIDI dongle: USB host to TRS MIDI]

Parts:
C1, C2: 1u; C_0603_1608Metric; MPN CL10A105KB8NNNC; LCSC# C15849
C3: 10u; C_0603_1608Metric; MPN CL10A106MA8NRNC; LCSC# C96446
C4, C5: 100n; C_0603_1608Metric; MPN CC0603KRX7R9BB104; LCSC# C14663
D1: 1N4148W; D_SOD-123; MPN 1N4148W; LCSC# C81598
D2: LED red 0603; LED_0603_1608Metric; MPN KT-0603R; LCSC# C2286
J1: 911-321B2028S10100; USB-A-SMD_911-321B2028S10100; MPN 911-321B2028S10100; LCSC# C42474
J2: TYPE-C-31-M-12; USB_C_Receptacle_HRO_TYPE-C-31-M-12; MPN TYPE-C-31-M-12; LCSC# C165948
J3, J4: PJ-320D; AUDIO-SMD_PJ-320D; MPN PJ-320D; LCSC# C521460
R2, R3: 5.1k; R_0603_1608Metric; MPN 0603WAF5101T5E; LCSC# C23186
R4: 6.8k; R_0603_1608Metric; MPN 0603WAF6801T5E; LCSC# C23212
R7: 10; R_0603_1608Metric; MPN 0603WAF100JT5E; LCSC# C22859
R8: 33; R_0603_1608Metric; MPN 0603WAF330JT5E; LCSC# C23140
R9: 220; R_0603_1608Metric; MPN 0603WAF2200T5E; LCSC# C22962
R10: 10k; R_0603_1608Metric; MPN 0603WAF1002T5E; LCSC# C25804
R11: 1k; R_0603_1608Metric; MPN 0603WAF1001T5E; LCSC# C21190
R12, R13: 100k; R_0603_1608Metric; MPN 0603WAF1003T5E; LCSC# C25803
TP1: +3V3; TestPoint_Pad_1.5x1.5mm
TP2: SDI_DIO; TestPoint_Pad_1.5x1.5mm
TP3: GND; TestPoint_Pad_1.5x1.5mm
U1: CH32X035G8U6; QFN-28_L4.0-W4.0-P0.40-BL-EP2.8; MPN CH32X035G8U6; LCSC# C7437027
U2: XC6206P332MR; SOT-23-3_L2.9-W1.6-P1.90-LS2.8-BR; MPN XC6206P332MR; LCSC# C5446
U3: SY6280AAC; SOT-23-5_L3.0-W1.7-P0.95-LS2.8-BL; MPN SY6280AAC; LCSC# C55136
U4: H11L1SM; SOP-6_L8.5-W6.4-P2.54-LS9.2-BL; MPN H11L1SM; LCSC# C899473
U5: SN74LVC1G3157; SOT-363_SC-70-6; MPN SN74LVC1G3157DCKR; LCSC# C38663

Connections:
+3V3: C2.1, C4.1, C5.1, R8.1, R10.1, TP1.1, U1.2 (VDD), U2.2 (VO), U4.6, U5.5 (VCC)
+5V_IN: C1.1, J2.A4 (VBUS), J2.A9 (VBUS), J2.B4 (VBUS), J2.B9 (VBUS), U2.3 (VI), U3.5 (IN)
/CC1_IN: J2.A5 (CC1), R2.1
/CC2_IN: J2.B5 (CC2), R3.1
/ISET: R4.1, U3.3 (ISET)
/LED: R11.1, U1.23 (PB12)
/LED_K: D2.2 (A), R11.2
/MIDI_IN_RING: D1.2 (A), J4.3 (RING), U4.2
/MIDI_IN_TIP: J4.4 (TIP), R9.1
/MIDI_OUT_DATA: R7.1, U5.4 (A)
/MIDI_RING_OUT: J3.3 (RING), R8.2
/MIDI_RX: R10.2, U1.22 (PB11), U4.4, U5.3 (B1)
/MIDI_TIP_OUT: J3.4 (TIP), R7.2
/MIDI_TX: U1.21 (PB10), U5.1 (B2)
/OPTO_A: D1.1 (K), R9.2, U4.1
/OUT_SEL: R13.1, U1.20 (PB9), U5.6 (S)
/SDI_DIO: TP2.1, U1.25 (PC18/DIO)
/USB_DM: J1.2 (D-), U1.26 (PC11/PC16/UDM)
/USB_DP: J1.3 (D+), U1.27 (PC10/PC17/UDP)
/VBUS_EN: R12.1, U1.8 (PA3), U3.4 (EN)
GND: C1.2, C2.2, C3.2, C4.2, C5.2, D2.1 (K), J1.4 (GND), J1.5 (SH), J1.6 (SH), J1.7 (SH), J1.8 (SH), J2.A1 (GND), J2.A12 (GND), J2.B1 (GND), J2.B12 (GND), J2.SH (SHIELD), J3.1 (SL), J3.2 (R2), R2.2, R3.2, R4.2, R12.2, R13.2, TP3.1, U1.29 (GND), U2.1 (GND), U3.2 (GND), U4.5, U5.2 (GND)
VBUS_HOST: C3.1, J1.1 (VBUS), U3.1 (OUT)

Notes on the sheet:
POWER IN (USB-C, 5 V only)
3.3 V LDO
USB HOST PORT (VBUS switch, 1 A limit)
MCU (CH32X035 USB host)
MIDI IN (TRS type A, opto-isolated)
MIDI OUT (TRS type A, 3.3 V) with hardware THRU
STATUS LED + WCH-LinkE PADS
FM-1 MIDI dongle v5: USB-A host port (bottom face) for any class-compliant USB-MIDI synth. JLCPCB build: PCB 0.8 mm, 4 layers; J1 on the bottom face, every other part on top. No D+/D- pull-downs: the X035 host port has them internally (RB_UH_PD_DIS = 0). TRS type A: tip = MIDI pin 5 (data), ring = 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

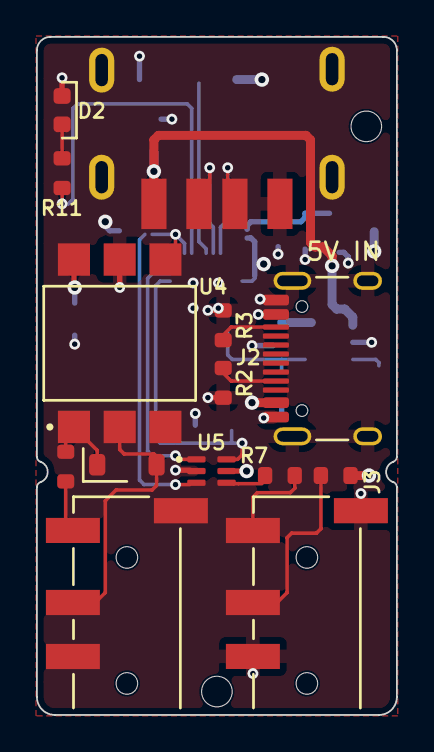
[picture p60: board fm1-midi-dongle.kicad_pcb from above]

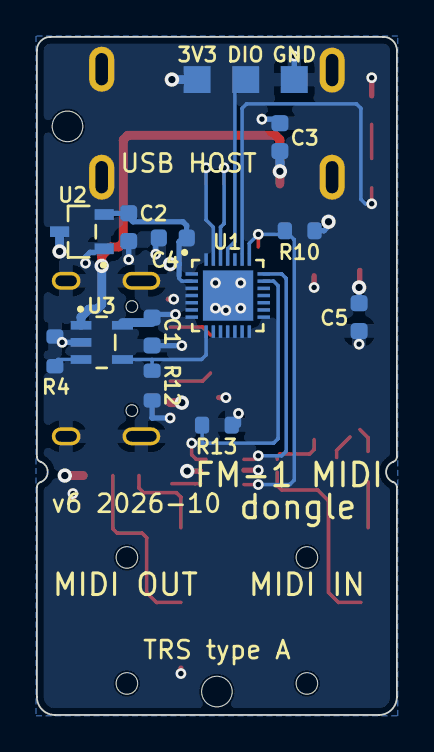
[picture p61: board fm1-midi-dongle.kicad_pcb from below]

Board: 4 copper layers, 20.0 x 37.7 mm, 31 parts (15 on the bottom side), 22 nets.

Other parts of the board:
H1, H2: M1.6 hole; MountingHole_1.7mm_NPTH
