wero1414/fm1-midi-dongle./(commit log)

2026-10-17 FM-1 MIDI dongle: design doc, BOM, KiCad schematic (CH32X035G8U6 USB host to TRS MIDI)
2026-10-17 Schematic: LCSC# field on every component; passives verified on lcsc.com
2026-10-17 BOM: LCSC number for R5/R6
2026-10-17 Replace the SDI pin header with three bare pads; nothing bulky on the stick
2026-10-17 Design for JLCPCB assembly: exact LCSC footprints from EasyEDA, PJ-320D jacks, 0.8 mm board for the edge-clamp plug, JLCPCB BOM export
    - footprints + 3D models for every IC and connector pulled with easyeda2kicad for the exact LCSC numbers
    - USB-C plug datasheet read: PCB 0.80 +/-0.05 mm, pads on both faces; JLCPCB Standard assembly only
    - PJ-320B dropped (EasyEDA entry is a dummy 'not a PCB-soldered part'); PJ-320D C521460 with pin map
    verified against KiCad's named PJ320D footprint (1 sleeve, 2 ring2, 3 ring1, 4 tip)
    - values are manufacturer part numbers so the JLCPCB Comment column is right; test pads out of the BOM
    - tools/export_jlc.sh -> production/bom_jlcpcb.csv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
2026-10-17 PCB floorplan: 18.9 x 26 mm, 4 layers, 0.8 mm, generated from the netlist with pcbnew
    - plug tongue edge with latch notches drawn exactly from the plug drawing; housing off-board
    - jacks at 9.3 mm pitch on the far edge, receptacle on the bottom right, opto bottom left,
    MCU top right in the hole-free band, passives in columns under the jacks
    - JLCPCB 4-layer rules, GND plane on In1, keep-out under the plug clamp; DRC clean except silk
    - R5/R6 DNP (X035 host port has internal pull-downs); deterministic schematic uuids so the
    PCB stays linked across regenerations
2026-10-17 Floorplan v2: signal-priority placement (USB pair straight under the plug, VBUS switch on the back-face pads, MIDI TX on top), 10 mm jack pitch, two inner GND planes, numeric pad-spacing and hole che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
2026-10-17 PCB v3: priority-driven floorplan and full routing, DRC 0 / unconnected 0
    - USB pair straight under the plug on F.Cu over the GND plane, no vias; DNP pull-downs removed (internal ones used)
    - VBUS on the plug's back-face pads only, SY6280 2.5 mm away on the back; In2 = +3V3 plane; vias tented
    - 10 mm jack pitch, receptacle on the right side, clamp keep-out both faces, numeric pad/hole spacing checks
    - routed with the KAT router (kicad-pcb-autorouter-workflow skill), cfg in tools/cfg_fm1.py; post-route GND via
    - Gerbers, Excellon, JLCPCB CPL + BOM, 3D renders, HTML layer viewer
2026-10-17 Revert to placement only: routing was not asked for; board back to the v3 floorplan, fab outputs removed
2026-10-19 PCB v4: single-sided placement, hand-written routing, silkscreen, rounded outline, case notches, 3D fixes
    - gen_pcb.py: single-sided 20 x 37.7 mm floorplan, passives oriented toward their nets,
    convex corners rounded, two side locating notches (y 22.2, r 0.6) for a captured case,
    J2 3D offset fixed, KiCad-library models pointed at vendored STEP files
    - route.py: explicit polylines (no autorouter), 45 deg bends only, no loops,
    0.2/0.3/0.5 mm tracks, 0.6/0.3 and 0.8/0.4 vias, GND planes and pours, +5V_IN pour
    - silk.py: regenerated silkscreen (clipped outlines, pin-1/cathode marks, 0.8 mm
    designators, test-pad and back labels)
    - check_loops.py, render_nets.py, render_route.py: review t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
2026-10-19 D2 to Basic red LED C2286 (green C72043 out of stock); add 3D views
    - gen_sch.py / BOM.csv: D2 KT-0603R (C2286, Basic): no Extended fee, ~1.3 mA via R11 1k
    - schematic and board regenerated: ERC 0, DRC unchanged (accepted items only)
    - docs/views: top, bottom, isometric front/back/under, side and front renders
    Claude-Session: https://claude.ai/code/session_01Dtfv3zuhZTs975LiSXznFQ
2026-10-19 Add hardware MIDI THRU: U5 SPDT switch selects OUT jack source
    SN74LVC1G3157DCKR (LCSC C38663) in front of R7/J3 tip: S low = MIDI_RX
    (opto output, hardware THRU), S high = MIDI_TX. S = OUT_SEL = PB9 with
    R13 100k pull-down so THRU is the default with a blank or resetting MCU.
    Layout: U5 between MCU and opto, C5 and R13 moved, TP3 (GND) moved to
    the pocket above the jacks. ERC 0, DRC only the 6 known J1 edge items.
    BOM, DESIGN.md and renders updated; SC-70-6 STEP vendored.
    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
2026-10-20 Add docs/AI-DESIGN-FLOW.md: tooling, pipeline, rules and gates used for v4
    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
2026-10-20 v5: USB-A host port on the bottom face, schematic cleanup, hand-routed
    - J1 = USB-A receptacle 911-321B2028S10100 (LCSC C42474) on B.Cu, mouth 0.8 mm
    past the top edge; board still 20 x 37.7 mm. Plug, R1 and CC_FM1 removed,
    VBUS_HOST, C3 now 10 uF (C96446) host-port bulk.
    - Schematic: power/ground as KiCad power symbols, no overlapping symbols or
    texts (generator checks it), clean symbols for SY6280, 3157, USB-A, PJ-320D.
    - THRU switch inputs swapped (B2 = MIDI_RX, B1 = MIDI_TX) and R13 is now a
    pull-up: THRU still default; firmware drives PB9 low for MCU MIDI.
    - Floorplan + hand-written routing (tools/route.py): DRC 0 unconnected, house
    style clean, 0 loops. One track_width neck a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
2026-10-20 DESIGN.md firmware plan: PA0/VBUS_EN drives the USB-A port power, R12 keeps it off by default
    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
2026-10-20 v6: flat-slab layout, hand-routed, slab case
    Owner rejected the v5 S-profile case (can't lie flat on a desk) and chose a
    re-placed board in a uniform 12.2 mm slab.
    - Board (still 20 x 37.7 mm): tall parts on top (USB-A J1 now on top, USB-C
    J2 on the right edge, jacks, opto, THRU switch, LED); parts <= 1.3 mm on
    the bottom (MCU, LDO, SY6280, caps, SDI pads).
    - Pins: VBUS_EN -> PA3 (pin 8), LED -> PB12 (pin 23); U5 B1 = RX, B2 = TX,
    R13 back to a pull-down (PB9 HIGH = MCU TX, default hardware THRU).
    - Routing (tools/route.py, hand-written polylines): +5V_IN as an island in
    In2; DRC 0 unconnected / 0 clearance, 0 loops, style clean. Open for
    owner sign-off: VDD 0.2 mm neck, one 0.6/0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
2026-10-21 v6.1: case screw holes, milled aluminium + printed + sheet-metal cases
    - board: two M1.6 case holes (H1 between the jacks, H2 beside the USB-A), board-only NPTH;
    silk keeps text off the case bosses; DRC back to the v6 baseline
    - case/gen_case.py: one design, CASE=alu (CNC 6061) or CASE=print. Split at the jacks' axis so
    every port is half in each half (the v6 snap case split at the board face could not close
    without the jack-end wall bending ~2 mm). 2 x M1.6 x 6 countersunk screws through the board.
    Pockets hug the parts and are shaped for the cutter radius.
    - case/gen_case_sheet.py: 0.8 mm 5052 two-U box (base: bottom + sides, cover: top + ends with
    M2 clinch-nut tabs), connectors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
